flyboy-byte/wideband-work/work/STATE.md

# STATE — rusEFI wideband (module + carrier)

Status: 2026-10-25 — board r41 + B1 fix + **R9 pulse-proof (C844867, round 6 R6-S3; layout unchanged)**; firmware unchanged since 2026-10-24 (comments only). Seven audit rounds; **round 7 (Codex/Astra, PR #3, 2026-10-25): no BLOCKER or BUG**, verdict "yes for a supervised first prototype"; R7-S1 (surge is a conditional budget) and R7-S2/S3 (+5V load list, doc headers) answered in wording, A8 now measures the whole +5V load. The release gate read the oldest audit round (AUDIT.md lists newest first): fixed, `checks/test_release.py`. Round 6 (Codex/Astra, PR #2) found two checker bugs that let failures pass (stack checker cut real recursion through pointers; sim wrappers passed aborted runs): both fixed with regressions that fail on the old code; one surge risk fixed by the R9 swap; two risks accepted (backfeed under C1, bench A8; C11 edge rails at the quote). **Released `flyboy-o2-v1` (2026-10-25, `fab/flyboy-o2-v1/`, carrier + module). Next: the owner orders at JLC (`docs/ordering.md`); then bring-up, and the order (owner).** U9 pinout closed (Torex, via round 6). Costs, route, shopping list: `ROADMAP.md`.
Revision in progress: flyboy-o2-v1 (released, not ordered)   Revisions used (never reused): flyboy-o2-v1 (released 2026-10-25, not yet ordered). Upstream module exports are rev A, B, C (upstream's own scheme, not ours).
<If the project already names revisions its own way (v1.0.0), keep its scheme.>
Review pages: status report https://claude.ai/artifact/YRsjXKGZKG5AFbwkcMuYZ4 (private; rebuilt by `checks/report.py`)  fit check <link>  audit <link>

## Stages
Mark a stage done only when its exit condition is true. Strike through, don't delete.

| # | Stage | Exit condition | Done |
| --- | --- | --- | --- |
| 1 | Requirements | `REQUIREMENTS.md` answered by the owner; breakout/perfboard ruled out | |
| 2 | Parts | Every part in `parts_research.md` with pinout, land pattern, temp rating, stock, source URL; real 3D model seen for user-handled and tall parts | |
| 3 | Schematic | Generated from code; netlist self-check passes | 2026-10-24 (r41: ERC 0, self-check 18/18) |
| 4 | Fit check | Artifact page with the to-scale picture and size table (mm + in) approved by the owner | |
| 5 | Placement | Fixed parts and critical loops locked; back side checked | 2026-10-24 (r41: stage on the top, bypass caps 2.1-3.9 mm, bottom carries tracks only) |
| 6 | Routing | Best run chosen by DRC count, not router score; vias out of SMD pads | 2026-10-24 (r41: 0 new incl. fab warnings, 0 open, 0 vias in pads, layout review 0) |
| 7 | 3D and mechanical | Access check done for every user-handled part; renders looked at, then published and approved by the owner | renders looked at and published (status page v3); jumpers on open top area, holes copper-free; **owner approval pending** |
| 8 | Fab files | `checks/run_all.py` all PASS (DRC included, nothing skipped) on the current design | 2026-10-24 candidate in `work/out/carrier/`: 20 checks pass, raw upstream DRC advisory by D2 |
| 9 | Audit | `AUDIT.md` round with no open BLOCKER or BUG; earlier fixes re-confirmed | |
| 10 | Order | `checks/release.py` released `fab/<rev>/`; committed the same day; row in `ORDERS.md` | |
| 11 | Bring-up | Bring-up tests from `REQUIREMENTS.md` run and recorded below; RISK items checked; lessons in `LESSONS.md` | |

## Decisions already made (do not re-ask)
- 2026-10-23 Owner answers, asked interactively (C1-C3, D1-D11) — owner:
  - C2 receivers: all of Speeduino, K20Z3/FlashPro, an AFR gauge, and rusEFI over CAN. K20Z3 input resistance UNKNOWN: measure it at bring-up. Endpoint tolerance +-0.05 V after a one-time bench trim. Not a forced change: the shortfall (4.816 V max into 10k, Codex runs) only touches the top near 20 AFR and only into a low-resistance input. First measure the K20Z3 input with a multimeter; at 100k or more the trim reaches +-0.05 V as is; if low, simulate 68k -> about 75k or set the receiver table from measured volts (owner agreed 2026-10-23).
  - 2026-10-24 C2 build-around (owner: "build around it", no way to measure the receiver): 68k DC feedback moves to J3-5 after R11 (E). Simulated: 1-5 V within 3 mV into 4.7k-100k pull-downs and 10k-47k pull-ups; below 1 V into a pull-up still unverified. `docs/carrier.md` "Receiver load and the feedback point". In the next board run.
  - 2026-10-24 Silkscreen default (Claude, reversible; owner may override): labels at JLC's 1.0 mm / 0.15 mm minimum, only where a label clearly belongs to its part; the jumpers carry their function (TEST, 120R) instead of JP1/JP2; 13 crowded passives unlabelled (CPL and renders name them).
  - 2026-10-24 Upstream's `hardware/board_carrier/export/` files are stale (BOM 2023-01-05: SMCJ30CA/SS34, no C6-C10; positions before the 2023-02-03 re-placement). Part numbers come from the board's LCSC fields: D1 SMCJ24CA C151279, D2 SS54 C22452 (DOCUMENTED, upstream git).
  - 2026-10-24 Mounting holes isolated: no copper within 3.6 mm of H1/H2 on either layer (Claude default, r41; the owner suggested a plastic washer instead, which still works; a grounded case via plated holes would be the owner's call).
  - D9 caveat: moving the stage to the top re-places a clean board to save an unpriced fee; price the two-sided fee first and come back to the owner if the saving is small.
  - C1 12-16 V on J3-5: no survival requirement ("how bad would i have to be"); R11 470R stays as limiting only; accepted risk. Realistic route: J3-5 sits between J3-6 (12V_RAW) and J3-4 (heater+), so a solder bridge or misplug.
  - C3 grounding: star at the ECU sensor ground. J3-1 power ground to block/battery; J3-7 only to the receiver's sensor ground; A4 measures the offset.
  - D1 R9 -> 1206. D2 gate on "DRC vs upstream" instead of raw DRC, plus a dated C7 waiver. D7 no separate analog ground. D8 two M3 holes in the new bottom corners. D9 analog stage, R10 and JP2 to the top (one-sided assembly). D10 add the IWDG watchdog. D11 keep the 13 V assumption.
- 2026-10-23 No size limit from upstream's `case/case.STL`: the owner designs his own enclosure in CAD ("what case. i do cad"). The carrier may grow; not going upstream, so no compatibility to keep. Next: fit check for a larger outline (about 40 x 52 mm), analog stage to the top if it fits, D6 series resistor — owner.
- 2026-10-23 Test and audit effort goes to the big things: circuits (analog stage, power), the heater drive, the control loops (heater, pump) and firmware. Lighter checks for routine parts and docs — owner.
- 2026-10-23 No simulated-narrowband output. FlashPro use is datalogging over the 0-5 V input; stock ECU closed loop stays on its narrowband sensor — owner.
- 2026-10-23 Base stays the f0 module + a new carrier; lambda-x2 is not forked (its analog out is the same circuit). Copy its output stage, add a reference buffer and trim — owner ("keep going").
- 2026-10-23 `AGENTS.md` is the authoritative guide for all models; Codex audits follow its "Cross-model audits" section — owner asked for documentation for us, subagents and Codex.
- ~~2026-10-23 Work in a separate repo, upstream clone stays untouched~~ — replaced the same day: one repo `~/projects/wideband-work` = upstream clone + branch `analog-out` + our files in `work/`; the separate notes repo and the `rusefi-hardware` clone were deleted — owner ("combine and delete").
- 2026-10-23 Intent: build and order the upstream design as is, then adapt it — owner ("both").
- 2026-10-23 Upstream's `hardware/*/export/` files are upstream releases, not evidence of anything the owner ordered.

- 2026-10-23 Aftermarket LSU 4.9 accepted; receivers wanted: rusEFI, Speeduino, K20Z3/FlashPro, carb tuning with a dash or gauge — owner.

- 2026-10-23 Owner wants to build this board ourselves and learn from it, not buy a ready-made unit; the point is the design and testing — owner.

## Checks
<!-- checks:start -->
| Check | Result | Summary | Date | Files (sha256/12) |
| --- | --- | --- | --- | --- |
| DRC module (errors) | FAIL (advisory) | DRC 11 errors: solder_mask_bridge 10, clearance 1 (report checks/out/wideband_controller-drc.json) | 2026-10-25 | `wideband_controller.kicad_pcb` 0179d031bc63 |
| Module board identical to upstream | PASS | module board vs upstream master: 0 file(s) differ | 2026-10-25 |  |
| ERC module (errors) | PASS | ERC 0 errors (report checks/out/wideband_controller-erc.json) | 2026-10-25 | `wideband_controller.kicad_sch` e54843a1e6ef |
| DRC carrier (errors) | FAIL (advisory) | DRC 23 errors: courtyards_overlap 14, copper_edge_clearance 3, malformed_courtyard 3, starved_thermal 2 (report checks/out/board_carrier-drc.json) | 2026-10-25 | `board_carrier.kicad_pcb` 986aced34840 |
| Carrier DRC vs upstream baseline (new violations, unconnected) | PASS | DRC vs upstream: 0 new violations, 0 unconnected | 2026-10-25 | `board_carrier.kicad_pcb` 986aced34840 |
| Carrier: no new vias in SMD pads | PASS | via in pad: 0 new, 0 upstream | 2026-10-25 | `board_carrier.kicad_pcb` 986aced34840 |
| Carrier layout review (sampled coupling and return-path heuristics) | PASS | review triggers: 0 | 2026-10-25 | `board_carrier.kicad_pcb` 986aced34840, `layout_review.py` 2dfa9e8efa14, `layout_metrics.py` 23c78d58fd8a |
| Layout geometry helper unit tests | PASS | OK | 2026-10-25 | `layout_metrics.py` 23c78d58fd8a, `test_layout_metrics.py` 2d93b205dd56 |
| Layout track-order regression | PASS | PASS: tested orders agree | 2026-10-25 | `board_carrier.kicad_pcb` 986aced34840, `layout_review.py` 2dfa9e8efa14, `layout_metrics.py` 23c78d58fd8a, `audit_layout_order.py` c40bda9f97e2 |
| ERC carrier (errors) | PASS | ERC 0 errors (report checks/out/board_carrier-erc.json) | 2026-10-25 | `board_carrier.kicad_sch` 7899a4c38db8 |
| Carrier netlist self-check (generator table) | PASS | netlist self-check: 18 nets, 0 problems | 2026-10-25 | `board_carrier.kicad_sch` 7899a4c38db8, `gen_carrier_sch.py` bc7a0b98744c |
| No hand edits waiting | PASS | no drift | 2026-10-25 |  |
| JLC rotation, origin and pin names from each part's EasyEDA footprint | PASS | jlc rotation: 38 parts measured, 4 need a correction, 0 problem(s) | 2026-10-25 | `board_carrier.kicad_pcb` 986aced34840, `board_carrier.kicad_sch` 7899a4c38db8 |
| Fab candidate (out/carrier) matches the board: Gerbers, BOM, CPL, not-fitted | PASS | fab files: 38 placed, 6 not fitted, outline 40.00 x 51.50 mm, 0 problem(s) | 2026-10-25 | `board_carrier.kicad_pcb` 986aced34840, `carrier-bom.csv` 4929cced2179, `carrier-cpl.csv` 66a7fdc2200c, `carrier-gerbers.zip` c6d03f1de870 |
| Firmware: bootloader DATA writes stay inside the app partition (F1) | PASS | 52 guard cases; 0 unsafe accepted writes, 0 valid writes refused (stub only) | 2026-10-25 | `bootloader.cpp` 21cbac0cd469, `bootloader_bounds.h` 72e216e2e7bc |
| Firmware: package checker accepts good images, rejects bad ones (F2) | PASS | 21 package cases, 0 wrong verdict(s) | 2026-10-25 | `fw_package.py` 34a1c5eb78dd, `wideband_image.h` 1ee39ace5944, `bootloader.cpp` 21cbac0cd469 |
| Firmware: HardFault entry reaches the C handler on a Cortex-M0 (F9, QEMU microbit) | PASS | fault entry on Cortex-M0: as expected | 2026-10-25 | `main_hardfault_asm.S` d32262764759, `main.cpp` f1c2e96ebf08 |
| Firmware: host gtest suite (sampler, heater, F7, F1 bounds, D10 watchdog) | PASS | [  PASSED  ] 70 tests. | 2026-10-25 | `heater_control.cpp` 7368eb50561e, `sampling.cpp` 8a229de01887, `watchdog.h` 3c55e521fda5, `bootloader_bounds.h` 72e216e2e7bc |
| Firmware: analog output host tests, production auxout/pump_dac/can_helper on the f0 config (F3-F6) | PASS | [  PASSED  ] 21 tests. | 2026-10-25 | `auxout.cpp` 417044786829, `pump_dac.cpp` ac1d4bf351de, `can_helper.cpp` 0dd77d348207, `aux_curve.h` bb88ea23e570, `wideband_board_config.h` 75af39efb19f |
| Firmware: static worst-case stack per thread fits (F8 estimate, f0 build) | PASS | stack estimate: ok, smallest margin 92 B | 2026-10-25 | `auxout.cpp` 417044786829, `can.cpp` 65a7078908bf, `heater_thread.cpp` 1c61085261f8, `pump_control.cpp` 6449053857fe, `sampling_thread.cpp` 65d58bbf0b52 |
| Stack checker: known-answer Cortex-M0 cases incl. a pointer in a literal pool (Codex R41-CX1) | PASS | stack checker cases: 4, 0 wrong verdict(s) | 2026-10-25 | `stack_estimate.py` b4a89208d6a3 |
| Sim wrappers fail when ngspice gives no valid result (Codex R41-CX2) | PASS | sim wrappers: 0 wrong verdict(s) | 2026-10-25 | `stability.sh` b5a591f40734, `load_accuracy.sh` ff3f503474e9 |
| Output low from reset until the app drives PB1 (R3 vs the PB1 pull in both board.h; outside review B1) | PASS | boot level: output low from reset | 2026-10-25 | `board_carrier.kicad_pcb` 986aced34840, `board.h` 0a70a2bb2fa0, `board.h` 1dc40c1c92c0 |
| Module order files: JLC rotation, origin and pin names from EasyEDA against the order CPL (upstream rev C + fixes) | PASS | jlc rotation: 57 parts measured, 6 need a correction, 0 problem(s) | 2026-10-25 | `wideband_controller.kicad_pcb` 0179d031bc63, `module_fab.py` fe36cd34cf0f, `jlc_rotation.py` b1455144624f |
| Reviewer docs agree with the repo (REVIEW.md check count, TASKS.md IDs and files, pack contents) | PASS | review docs: 0 problem(s) | 2026-10-25 | `REVIEW.md` 4ca0666dfb44, `TASKS.md` d7455f56fb34, `FINDINGS-TEMPLATE.md` 7d85be0c9a6e, `review_pack.sh` fbeab94d332c, `checks.json` 65fa8b4c7038, `AUDIT.md` 50b4673514ca |
| Op-amp supply survives a clamped load dump: R9 and D5 power within rating (Codex round 6, R6-S3) | PASS | surge budget: 0 problem(s) | 2026-10-25 | `board_carrier.kicad_pcb` 986aced34840, `surge_budget.py` a12d878ff9c3 |
| Release gate judges the latest audit round, wherever AUDIT.md lists it (Codex round 7 follow-up) | PASS | release gate rounds: 4/4 right | 2026-10-25 | `release.py` cc666e23c085, `test_release.py` 3cb68936a838 |

Written by `checks/run_all.py` at commit 9481317. Don't edit by hand.
<!-- checks:end -->

## Bring-up results
| Test | Board # | Reading | Pass? | Date |
| --- | --- | --- | --- | --- |

## Firmware tested on
| Board revision | Firmware commit | Result |
| --- | --- | --- |

## Open register (2026-10-25)
- 2026-10-25: round 6 answered in `AUDIT.md` (all 8 findings: 5 fixed, 2 accepted, plus doc items). Design change: R9
  C4410 -> C844867 (Claude's call under the owner's 2026-10-24 delegation; +$3 Extended fee, +$0.48 parts for 5 boards;
  REPORTED). Its check: `checks/surge_budget.py` (fails on C4410); bench: none possible on the owner's bench (no
  surge source), so the check and round 7 TK3 carry it. Round 7 hand-off and `review/TASKS.md` (TK1-TK7) ready.
- PR #2 (Astra's review folder only) merged to keep the raw report with its round.

## Open register (2026-10-24, end of session)
- 2026-10-24 late: reviewer docs rebuilt for a cold agent (owner: Astra Codex "didn't really know what all to do and how
  to help"). `REVIEW.md` leads with three rules (work without waiting, write as you go, stop at a quarter budget) and
  two routes (agent with the repo; chat with one zip). Work list `review/TASKS.md` (TK1-TK13), report
  `review/FINDINGS-TEMPLATE.md` (coverage row per task, two worked examples), chat prompt `review/PROMPT.md`. The pack
  gained plain-text part and net lists for both boards (`checks/pack_extras.py`), the module Gerbers, `INDEX.md` and a
  zip; the old pack silently lost the carrier's README and not-fitted list (same basenames as the module's;
  `audit_pack.py` now refuses that). New check `checks/review_docs.py` (count, task IDs, pack files, scripts). Local
  only: not pushed.
- Owner (2026-10-24, do not re-ask): don't send our lessons back to the cousin's skill.
- 2026-10-24 evening: owner delegated B1/N1/R1 and the heater clamp to Claude and said push everything (his cousin's review, Codex's PR and second pass, our tests). Done: `AUDIT.md` rounds 4 and 5 with follow-through; `ROADMAP.md` for the route. Watch for a PR from the cousin (he may not be finished) or anyone else.
- 2026-10-24 External-review prep done: `REVIEW.md`; checks use `origin/master` when a clone has no local `master` (`checks/upstream_ref.py`); reviewers' raw output under `audit/<reviewer>-<date>/` is now tracked (packs are not); a fresh clone ran all 20 checks after building bootloader + app (stack check needs the ELF). pcb-design skill lessons added (pad pairing by pin function, fab warnings in the DRC gate, BOM from the board, independent fab-file check, outside reviewers, SPICE memory): dotfiles commit 70aa5e9, pushed 2026-10-24.
- Owner (do not re-ask): engine-bay heat is not a design driver for this prototype.
- Owner (2026-10-25, do not re-ask): first order is 1-2 controllers. JLC makes 5 bare PCBs minimum and can assemble 2 of them (FROM MEMORY; check the quote), so assemble 2 carriers + 2 modules; the other 3 of each stay bare as spares. Same released files, quantity set on the order page.
- Owner (2026-10-25, do not re-ask): the module is **socketed** on the carrier (Mill-Max 310 sockets + 350 pins, `ROADMAP.md`); no board change. Round 8 OR1/OR2 answered in AUDIT.md; OR3 (order notes) and OR4 (first-power source) open.
- Owner (2026-10-25): **one order only, make or break.** Order on hold until a pre-order first-run risk pass: every way the first power-up, flash or sensor run can fail, whether it is recoverable with an iron, meter or reflash, and what closes it before ordering. Goal: no failure that only a second order can fix.
- Owner (2026-10-24, do not re-ask): first-flash hardware (D4) = HiLetgo ST-Link V2 clone + TC2030-IDC-NL + jumpers (`docs/wiring.md`).
- ~~Owner (2026-10-24): no pushing or merging until the outside reviewer (his cousin's Opus) has audited; keep working locally.~~ Lifted 2026-10-24 late (owner: the cousin isn't contributing now, push it all); review docs pushed `d801998`. Round 6 next: Astra (Codex) on this machine, started from the route B prompt in `REVIEW.md`. Upstream's own analog output (PR #352, merged 2026-10-24) is not used: we use our design (`docs/analog-out.md`).
- 2026-10-24 Codex round 4 on fork PR #1 (not merged). CX1 stack checker and CX2 sim wrappers fixed locally (`AUDIT.md`, follow-through part 1). Upstream heater bug (negative voltage squared to full duty when the sensor runs hot): fix prepared on local branch `heater-clamp`, owner decides.
- **Board/fab**: audit round 4 (Codex, plus an outside Opus reviewer via `REVIEW.md`): ~~rebuild the pack first~~ done 2026-10-24 at r41 (`checks/review_pack.sh`). ~~Push needed before an outside reviewer can clone~~ pushed 2026-10-24. JLC quote (owner): Gerbers in JLC's viewer, placement preview (D2 first), stock C13585/C14663/C15849/C7934, edge rails (C11 1.85 mm from edge), Basic 470R 1206 for R11. ~~TODO `docs/ordering.md`~~ written 2026-10-24 (quote steps, options, placement-preview list, substitution rule, APIs).
- **Module board (not prepared)**: upstream rev C exports current (2026-03-22); 4 layers, 29.0 x 20.9 mm, 60 parts; J1/J3 headers bottom (owner solders), J2 Tag-Connect pads. Run our rotation/fab checks on it.
- **Firmware**: never run on hardware; first-flash hardware unchosen (D4, money); trim needs reflash per board; watchdog heater loop only (W1); stack high-water on hardware; RAM 0 B free; F1/F9 not reported upstream (owner).
- **Deeper tests not done**: R9/D5 surge (Codex C6); 12 V on J3-5 as built (C1 accepted); supply corners: 5 V into 100k holds from 7.5 V battery up (4.34 V at 6 V); 4.7k and 7 V runs gave no result, redo; drift budget INFERRED: 60 C swing worst 40 mV at 5 V.
- **Bench**: T1, A1-A4 (A3 about 6 mA), W1, H1-H6.
- ~~More 3D views~~ done 2026-10-24: `renders/carrier-f/iso-{front,back,bottom}.png` (kicad-cli `--perspective --rotate`), on the status page v4.

## Open (older notes, 2026-10-23)
- 2026-10-23 Flashing/testing scoped in `docs/flashing-and-test-plan.md`: recommend SWD first-flash/recovery, exact probe/cable/power unchosen. Fresh native build passes 43 tests (leak check disabled due environment), not aux-output coverage. F1: bootloader DATA guard permits config-page writes; reproduced with actual guard + flash stub. Next: fix/test F1, validate image packaging, add aux-output host tests. No hardware flashing or purchases.
- 2026-10-23 Codex follow-up: layout metric repaired and regression-tested; PWM return review flag is 6.8 mm (C7). Four ramped full-scale model runs succeeded: about 5.019 V into 100k, 4.816 V into 10k, at protected supplies 12 V and 7.5 V. C1/C2/C3 remain open. Default: retain components until load/tolerance and clamp/sink behavior are jointly budgeted. 80R instead of 470R is not a standalone accuracy fix. See audit report follow-up. Long paragraph below is historical context, not current layout status.
- Analog output: `docs/analog-out.md`, `docs/carrier.md`, `docs/firmware.md`, `sim/analog_out.cir`. Firmware on branch `analog-out` builds (2026-10-23): PB1/TIM3_CH4, updated from the CAN TX thread, compiled-in 10-20 AFR curve, 0 V while invalid, full scale 5.04 V; 4.8 KB flash, 8 B RAM left; untested on hardware. Carrier analog stage proposed with parts (REF3030 C38423, 74LVC1G125 C12519, LM2904DR C7934, BAT54S C47546) and a behavioral filter simulation (0.7 mV ripple, 4.1 ms settling). Op-amp stability checked with TI's LM2904 model: feedback after the 330R oscillates; dual loop with Cf 1 nF has no overshoot from 1 pF to 47 nF (`sim/stability.sh`). Firmware test mode (SEL_2 low at power-up) and compiled-in trim added; RAM now full to the byte (no runtime allocation, so safe). Carrier schematic generated from code (`gen/gen_carrier_sch.py`, A3 sheet, upstream drawing kept): ERC 0 errors, netlist self-check 17/17 nets (2026-10-23). Carrier PCB in progress (`gen/gen_carrier_pcb.py`, 2026-10-23): new parts on the bottom (board can't grow inside `case/case.STL`; case clearance under the board about 6 mm, INFERRED); placed by an annealing placer (net length + distance to existing copper), GND fan-out vias and +5V tap vias before routing, Freerouting 2.5.0 with upstream tracks locked, then a grid finisher (`gen/finish_routes.py`) for what Freerouting leaves. Passives moved to 0402 where the rating allows (2026-10-23, to free bottom area; R6/R8/R9/C16/C17 stay 0603/1206). Analog-stage nets routed by negotiated routing (`finish_routes.negotiate`) before Freerouting. Routing closed 2026-10-23 (r32): `checks/drc_vs_upstream.py` = 0 new violations, 0 unconnected; the last open connection (D3 clamp to +5V) was fixed by `close_d3_link` in the generator, found with `checks/whatif_route.py`. **Not done (updated 2026-10-23 evening):** self-audit done, see `RELEASE_ASSESSMENT.md`; firmware fix R4 (CAN thread no longer waits 100 ms with no node on the bus); the C17 move was tried (r33, weighting `/VOP12`) and reverted (6 open). C17 sits 4.5 mm from U6 pin 8 (fix before review); silkscreen overlaps; audit (pack in `work/audit/carrier-d-2026-10-23/`, hand-off in `AUDIT.md`); BOM/CPL and JLC quote. Run history and next steps in `HANDOFF.md`. The board file in the repo is this WIP state; don't order from it (release.py would refuse anyway). For the audit: R8 (330R) and R9 (1k) are 0603 (100 mW); an AOUT short to GND or a load-dump surge into the zener exceeds that briefly or steadily (INFERRED, not simulated); consider 0805/1206 or a pulse-rated part. Open: how the owner will flash the module (SWD probe or rusEFI over CAN). Open: invalid-output value (owner), owner to confirm tests A1-A3.
- Baseline checks on upstream at its HEAD (2026-10-23, error level): module DRC 11 / ERC 0; carrier DRC 29 / ERC 8. Not yet judged as real or harmless.
