flyboy-byte/wideband-work/work/audit/astra-2026-10-25b/PR-BODY.md

## Verdict

Suitable for a supervised first prototype after the existing factory rail/placement checks; not a qualified automotive/fault-survival product. No new BLOCKER or BUG found in this targeted round. Design baseline **18b6cef4c5ca249423fce5a9924ea7fc53124220**.

## Evidence

- TK1: prior recursion counterexample now fails;4/4regressions pass.40BLX sites/source target sets checked,current worst thread margin92B with stated assumptions.
- TK2:26sim-failure verdicts correct,actual aborted outputs rejected;real25case stability sweep completes,0%overshoot through10nF as-built.
- TK3: HP R9 nominal overload fixed(0.480W with tolerance vs conditional0.75W rating). D5 derating and actual400ms TVS envelope still qualify survival claims.
- TK4: no guaranteed13.6mA minimum+5V sink. LM2904 is on VOP12,not+5V. Keep accepted C1 prototype trade-off;no no-layout swap recommended without normal-operation revalidation.
- TK5: fresh26BOM/38CPL match;R9 geometry unchanged;all26live stock lines sufficient for5boards. Full suite26checks,0nonadvisory failures,2accepted DRC advisories,0skips;report isolation verified. C11 factory rail approval remains order-time gate.
- TK6:19new ASan/UBSan cases exercise real sampler+heater:synthetic ESR fault invalid526–576ms,DC fault firstsample;ADCstall confirms known freshness limitation. Not physical unplug qualification.
- TK7: concrete doc corrections proposed;coverage/verdict/handoff complete.

Only **work/audit/astra-2026-10-25b/** changes. Each TK has its own commit. No design changes,ordering,flashing,merge or pushes to analog-out/main.

Start with `work/audit/astra-2026-10-25b/FINDINGS.md`,then `HANDOFF.md` in the same folder. Commands,raw outputs,checks JSON and candidate BOM/CPL evidence are retained alongside them. TI's licensed model is not committed.
