flyboy-byte/wideband-work/work/audit/astra-2026-10-25/HANDOFF.md

# Round6 reviewer handoff

Performed2026-10-24; folder/branch2026-10-25 per owner's request. Reviewed design e0b802a5ca53d679b9fa85e5889658d3f74d6dab. Every commit on review/astra-2026-10-25 changes only this audit folder. PR:https://github.com/flyboy-byte/wideband-work/pull/2

Read FINDINGS.md first. Complete coverage TK1–TK13 plus TK99;2BUG,3RISK,3NOTE. Verdict: not yet a release/order package. No design files changed, no flash/order. Original owner's KiCad carrier lock preserved. Check-generated timestamp-only diffs outside the audit were restored precisely; no unrelated edits reverted.

## Designer's next steps

1. Verify **R6-S6** using stack_indirect_cycle.py/TK12-indirect-cycle.S. A real indirect recursive helper allocates108B per level; current checker passes116/256B. Reject cycles unless infeasibility is proved; avoid the verbose-path hang. Existing3regressions all pass and miss this case.
2. Verify **R6-S8** with sim_zero_regression.py and actual TK6c-long-*.out. Aborted analyses can emit finite zeros. Require final time/window completion and reject abort diagnostics; extend regressions to full_scale_corners.sh. The audit's own initial PASS labels are also superseded explicitly in TK99-sim-validation.md.
3. Obtain JLC rail/panel acceptance for C11. Published requirement is2.5mm from **body**, not center; current body clearance~1.60mm.5mm rails may resolve it without moving the circuit.
4. Resolve/qualify/explicitly accept the power-off backfeed and exact-part400ms surge risks. Do not claim current limiting proves ECU protection or continuous power rating proves pulse survival.
5. Correct3mVtyp vs7mVmax LM2904 offset; qualify optional ground-fuse protection; delay stability step to a settled baseline. Rebuild next audit pack after designer changes; preserve this review's raw output separately.

## Evidence worth reusing

- TK1-rows.md:26BOM/38CPL rows; TK2-rotation.log:57module placements. Torex primary PDF settles U9 pinout correctly.
- TK5-recovery-fixed.log:60s hot clamp then recovery;30cycles. Initial compile failure retained. Source tests are actual controller/PID with mock sampler/time, not thermal simulation.
- TK6-fullscale.log:27nominal values; raw-completion proof is only the3selected TK6-raw-*.out cases. Accepted deficit endpoints4.9338/4.8218V directly reproduced with valid60ms windows.
- TK6c-zero-*.out: model floor0.517V into4.7kdown/1.298V into4.8V pull-up; physical low-end remains unverified.
- TK7-delayed.log: settled baseline,0%overshoot to10nF,9.2%47nF,22.8%100nF. Typical model/12V/100k, not phase margin or process corners.
- TK12-checks.json:25checks,23passes,2accepted advisory failures. Fresh isolated build imageCRC984fc2b4,21616Bapp; no dynamic allocation symbols/heap space. Stack margin not proven.

Simulator quirk: run TI model with sim/.spiceinit(`ngbehavior=psa`). 'Exit0+finite numbers' is insufficient. Extra120ms/20us-timestep supply-start attempts failed numerically and are not circuit failures. Original queue ran all25A–E cases before the focused delayed E rerun; no raw run is silently relabeled.

Reproducers intentionally return0 when they reproduce the current checker bug; after a fix their expectations must be inverted into normal regression tests. Preserve historical evidence instead of overwriting it in another review folder. Strong-model follow-up can focus on R6-S2/S3 circuitry and the proposed checker proofs rather than rerunning all routine checks.
