flyboy-byte/wideband-work/work/audit/astra-2026-10-25/PR-BODY.md

Independent round6 review of design commit `e0b802a` on `analog-out`, covering TK1–TK13 plus a simulator-validation counterexample. Only `work/audit/astra-2026-10-25/` changes; no circuit, layout or production firmware changes.

Verdict: not yet an order/release package. Two reproducible verification bugs remain:

- **R6-S6:** actual indirect recursion is reported as116/256bytes and passes; verbose path printing hangs.
- **R6-S8:** ngspice can abort early yet return finite zero measurements; the production full-scale wrapper accepts27/27 injected aborted-zero cases.

Other findings: obtain JLC rail acceptance for C11's~1.60mm body clearance against the published2.5mm requirement; qualify the existing rail-backfeed and surge risks; correct LM2904 offset limits, fuse-protection wording and pre-step settling metrics. No new proven reversed part, open connection or production heater-control defect was found.

Validation:70host+21auxiliary+2new heater recovery tests pass; fresh firmware package builds and passes CRC/vector checks;25configured checks yield23passes and2accepted upstream advisory DRC failures. Nominal27case analog sweep reproduces;3selected corners independently retain raw60ms completion. Delayed-baseline step tests show0% overshoot through10nF,9.2% at47nF. Two extended supply-start analyses abort and remain explicitly unverified.

See `FINDINGS.md` for all8findings, per-task coverage, evidence tags and limitations. `HANDOFF.md` names the smallest next steps. No boards ordered or flashed. Review started before the owner's Astra→6.1Sol switch and continued afterward; it is one continuous reviewer, not two independent audits.
