flyboy-byte/wideband-work/work/audit/astra-2026-10-25/TK7-stability.md

# TK7 stability method review

DOCUMENTED: sim/stability.sh as-built E uses DC feedback from connector through68k, local1nF feedback from op-amp output,330+470ohm isolation,100k receiver,12V ideal rail,0.1V input step. The original queue had loaded its earlier code and ran all25A-E cases(TK7-stability.log). A focused E rerun waits3ms before the step and measures through6ms(TK7-delayed.log), recording source hash.

INFERRED: the isolation resistance limits direct capacitive loading of the output; local feedback takes over above the68k/1nF frequency scale(~2.34kHz). A bounded, decaying step response across the requested capacitances supports nominal closed-loop stability. It does not prove phase margin, all-parts stability, or response after saturation.

MEASURED delayed E results:0% overshoot at1pF/1nF/10nF,9.2% at47nF,22.8% at100nF;1% settling258/255/219/95/609us. All have late ripple printed0.00mV. Baseline1.6823V,terminal1.8503V. Original400us step test at10nF starts from1.7532V, not settled1.6823V;100nF overshoot was28.0% from an even more disturbed baseline. R6-S7: require settled baseline before quoting overshoot; nominal0..10nF conclusion survives the correction. These are completed nominal step tests, not a phase-margin measurement.

Limits of the test: one positive step around1.7-1.85V output,100k resistive load,ideal12V source,no clamp conduction,one macromodel and temperature. Neither negative steps nor the4.7k receiver/supply corners are covered. The TI model is typical; output crossover, current-limit recovery, saturation recovery, supply-startup behavior and process spread may differ from hardware. A loop-gain injection test (maintaining the DC operating point and both feedback paths) is appropriate for phase margin. Bench step/oscillation tests at several output levels and real cable loads would complement it. No phase-margin value is invented from overshoot.
