flyboy-byte/wideband-work/work/audit/claude-sidewinderzz-2026-10-24/netlist-from-board.txt

C1 1u C15849 1=/LSU_Heater+ 2=GND
C10 10u C13585 1=/LSU_Heater+ 2=GND
C11 100n C1525 1=+5V 2=GND
C12 100n C1525 1=/VREF3 2=GND
C13 100n C1525 1=/AOUT_F1 2=GND
C14 100n C1525 1=/AOUT_F2 2=GND
C15 1n C1523 1=/AOUT_OA 2=/AOUT_INN
C16 10u C13585 1=/VOP12 2=GND
C17 100n C14663 1=/VOP12 2=GND
C2 1u C15849 1=+5V 2=GND
C3 1u C15849 1=Net-(U1-VIO) 2=GND
C4 47p C1567 1=GND 2=/CAN_H
C5 47p C1567 1=/CAN_L 2=GND
C6 22u C45783 1=+5V 2=GND
C7 10u C13585 1=12V_RAW 2=GND
C8 10u C13585 1=GND 2=12V_RAW
C9 10u C13585 1=12V_RAW 2=GND
D1 D_TVS C151279 1=12V_RAW 2=GND
D2 D_Schottky C22452 1=/LSU_Heater+ 2=12V_RAW
D3 1N4148WS C2128 1=+5V 2=/AOUT
D4 1N4148WS C2128 1=/AOUT 2=GND
D5 18V C173425 1=/VOP12 2=GND
H1 MountingHole_3.2mm_M3 - 
H2 MountingHole_3.2mm_M3 - 
J3 Conn_02x06_Top_Bottom - 1=GND 2=/LSU_Ip 3=/LSU_Heater- 4=/LSU_Heater+ 5=/AOUT_J 6=12V_RAW 7=GND 8=/LSU_Vm 9=/LSU_Rtrim 10=/LSU_Un 11=/CAN_H 12=/CAN_L
JP1 TEST - 1=/TEST_SEL2 2=GND
JP2 CAN_TERM - 1=/CAN_TERM 2=/CAN_L
R1 220 C22962 1=+5V 2=Net-(U1-VIO)
R10 120 C25079 1=/CAN_H 2=/CAN_TERM
R11 470 C4502 1=/AOUT 2=/AOUT_J
R2 470 C23179 1=Net-(U1-VIO) 2=GND
R3 100k C25741 1=/AOUT_PWM 2=GND
R4 3.3k C25890 1=/AOUT_BUF 2=/AOUT_F1
R5 3.3k C25890 1=/AOUT_F1 2=/AOUT_F2
R6 68k C23231 1=/AOUT_J 2=/AOUT_INN
R7 100k C25741 1=/AOUT_INN 2=GND
R8 330 C23138 1=/AOUT_OA 2=/AOUT
R9 1k C4410 1=/LSU_Heater+ 2=/VOP12
U1 TJA1051T-3 C38695 1=/CAN_TX 2=GND 3=+5V 4=/CAN_RX 5=Net-(U1-VIO) 6=/CAN_L 7=/CAN_H 8=GND
U2 LM78M05_TO252 C58069 1=/LSU_Heater+ 2=GND 3=+5V
U3 f042_wideband_module - 1=+5V 2=GND 3=/AOUT_PWM 4=/TEST_SEL2 5=/CAN_RX 6=/CAN_TX 7=/LSU_Heater+ 8=unconnected-(U3-Boot0-Pad8) 9=GND 10=GND 11=/LSU_Heater- 12=/LSU_Heater- 13=/LSU_Ip 14=/LSU_Vm 15=/LSU_Rtrim 16=/LSU_Un
U4 74LVC1G125 C12519 1=GND 2=/AOUT_PWM 3=GND 4=/AOUT_BUF 5=/VREF3
U5 REF3030 C38423 1=+5V 2=/VREF3 3=GND
U6 LM2904 C7934 1=/AOUT_OA 2=/AOUT_INN 3=/AOUT_F2 4=GND 5=GND 6=/U6B_FB 7=/U6B_FB 8=/VOP12
