flyboy-byte/wideband-work/work/report/index.html

rusEFI wideband + 0-5 V analog out · carrier board · 2026-10-24 · commit ba01449 · branch analog-out

# Wideband Carrier Status

Board r41 + B1 fix (2026-10-24): output held at 0 V from reset (R3 4.7k, PB1 pull-down), invalid lambda reads 5 V (lean end), heater no longer heats a hot sensor. Five audit rounds; round 6 (re-audit of these changes) is next, then your JLC order: about $180-215 for 5 carriers + 5 modules, every part in stock. Route and shopping list: work/ROADMAP.md.

## Checks

Result | Check | Detail
FAIL | DRC module (errors) | DRC 11 errors: solder_mask_bridge 10, clearance 1
PASS | Module board identical to upstream | module board vs upstream master: 0 file(s) differ
PASS | ERC module (errors) | ERC 0 errors
FAIL | DRC carrier (errors) | DRC 23 errors: courtyards_overlap 14, copper_edge_clearance 3, malformed_courtyard 3, starved_thermal 2
PASS | Carrier DRC vs upstream baseline (new violations, unconnected) | DRC vs upstream: 0 new violations, 0 unconnected
PASS | Carrier: no new vias in SMD pads | via in pad: 0 new, 0 upstream
PASS | Carrier layout review (sampled coupling and return-path heuristics) | review triggers: 0
PASS | Layout geometry helper unit tests | OK
PASS | Layout track-order regression | PASS: tested orders agree
PASS | ERC carrier (errors) | ERC 0 errors
PASS | Carrier netlist self-check (generator table) | netlist self-check: 18 nets, 0 problems
PASS | No hand edits waiting | no drift
PASS | JLC rotation, origin and pin names from each part's EasyEDA footprint | jlc rotation: 38 parts measured, 4 need a correction, 0 problem(s)
PASS | Fab candidate (out/carrier) matches the board: Gerbers, BOM, CPL, not-fitted | fab files: 38 placed, 6 not fitted, outline 40.00 x 51.50 mm, 0 problem(s)
PASS | Firmware: bootloader DATA writes stay inside the app partition (F1) | 52 guard cases; 0 unsafe accepted writes, 0 valid writes refused (stub only)
PASS | Firmware: package checker accepts good images, rejects bad ones (F2) | 21 package cases, 0 wrong verdict(s)
PASS | Firmware: HardFault entry reaches the C handler on a Cortex-M0 (F9, QEMU microbit) | fault entry on Cortex-M0: as expected
PASS | Firmware: host gtest suite (sampler, heater, F7, F1 bounds, D10 watchdog) | [ PASSED ] 70 tests.
PASS | Firmware: analog output host tests, production auxout/pump_dac/can_helper on the f0 config (F3-F6) | [ PASSED ] 21 tests.
PASS | Firmware: static worst-case stack per thread fits (F8 estimate, f0 build) | stack estimate: ok, smallest margin 64 B
PASS | Stack checker: known-answer Cortex-M0 cases incl. a pointer in a literal pool (Codex R41-CX1) | stack checker cases: 3, 0 wrong verdict(s)
PASS | Sim wrappers fail when ngspice gives no valid result (Codex R41-CX2) | sim wrappers: 0 wrong verdict(s)
PASS | Output low from reset until the app drives PB1 (R3 vs the PB1 pull in both board.h; outside review B1) | boot level: output low from reset
PASS | Module order files: JLC rotation, origin and pin names from EasyEDA against the order CPL (upstream rev C + fixes) | jlc rotation: 57 parts measured, 6 need a correction, 0 problem(s)

Module DRC (11) and carrier DRC (23) are upstream's own errors, advisory by your decision D2. "vs upstream" counts only what we added, including fab-relevant warnings.

## The board now

Top view, 3D render (KiCad 10), r41 + B1 fix (2026-10-24): upstream carrier grown 15 mm (40.0 x 51.5 mm, 1.57 x 2.03 in); the analog stage, both jumpers and the M3 holes in the new strip.

Top view, 3D render (KiCad 10), r41 + B1 fix (2026-10-24): upstream carrier grown 15 mm (40.0 x 51.5 mm, 1.57 x 2.03 in); the analog stage, both jumpers and the M3 holes in the new strip.

Bottom view (mirrored), r41 + B1 fix: tracks only in the strip, copper-free rings around the holes.

Bottom view (mirrored), r41 + B1 fix: tracks only in the strip, copper-free rings around the holes.

Angled, perspective (r41 + B1 fix): the new strip in front, the sensor connector behind.

Angled, perspective (r41 + B1 fix): the new strip in front, the sensor connector behind.

From the connector end: the stage and the module footprint.

From the connector end: the stage and the module footprint.

Underneath: the pad labels (AOUT, GND, CAN, LSU pins) and the copper-free rings around the M3 holes.

Underneath: the pad labels (AOUT, GND, CAN, LSU pins) and the copper-free rings around the M3 holes.

## Before and after: the stage moves to the top

r36 had the analog stage on the bottom of the new strip (left). r41 has it on the top (right), so every SMD part is on one side and JLC's Economic assembly applies. The op-amp now takes its feedback at the output pin, after R11, so the receiver's input doesn't shift the reading; R9 is 1206; the two M3 holes have no copper under a screw head; the jumpers are labelled TEST and 120R.

Before (r36): the stage on the bottom of the strip.

Before (r36): the stage on the bottom of the strip.

After (r41): the stage on the top, one-sided assembly.

After (r41): the stage on the top, one-sided assembly.

## Runs and open decisions

Each run regenerates and routes the whole board, then scores it: DRC against upstream's own errors, vias in pads, and checks/layout_review.py (noisy nets beside sensitive ones, return paths under tracks, ground pour). Decisions are yours; the default in use is listed.

ID | What | State | Result / default
r33 | Pull C17 toward the op-amp on the old small board (placement weight). | DONE | 6 open connections: reverted. Showed the small board was the limit.
r34 | Grow 15 mm, stage into the strip, add R11, keep all upstream tracks. | DONE | 0 new / 0 open first try. Layout review: CAN_L ran 0.3 mm beside the output for 6.8 mm.
r35 | Move the CAN terminator off the output's corridor. | DONE | Coupling clean (nothing within 1 mm). C17 still 6.1 mm from its pin.
r36 | Start C17/C15 on the right side of the chip; tie caps to their pins. | DONE | 0/0/0, no review flags; C17 2.1 mm, C15 2.3 mm. Current board.
D7 | Separate analog ground for J3-7 on the board (heater current shares the ground wires). | DONE | No board change (your decision). Bring-up test A4 measures the real ground offset.
D8 | Mounting holes in the new bottom corners for your enclosure. | DONE | Done r37: two M3 holes; r41 keeps copper 3.6 mm clear of them.
D9 | Put the analog stage on the top of the strip for one-sided (cheaper) JLC assembly. | DONE | Done r37: every SMD part on the top. Economic $8 setup vs $50 two-sided (JLC help, 2025-09).
D1 | R9 (op-amp supply resistor) 0603 to 1206 for long surges. | DONE | Done r37: R9 1k 1206 (C4410).
r37 | Stage to the top; feedback from J3-5 after R11; R9 1206; M3 holes. | DONE | 0 new DRC, 0 open; PWM return gap 4.1 mm (C7 cleared).
r38 | Merge same-net vias drilled too close; DRC check counts fab warnings. | DONE | Found a hole_to_hole pair hidden since about r26; fixed.
r39-r40 | Silkscreen at JLC minimum, labels only where they belong; fab export. | DONE | 11-12 labels, TEST and 120R on the jumpers; BOM 25 lines, CPL 38 parts.
JLC | Rotation, origin and pin names from each part's EasyEDA footprint. | DONE | 4 rotation fixes, U2 shifted 0.725 mm, D2 would have gone on backwards by pad number: fixed.
r41 | No copper under the screw heads. | DONE | Pour was 0.3 mm from the holes; now 3.6 mm.
D10 | Watchdog on the heater loop. | DONE | 0 B RAM, 5 host tests, bench self-test build W1.
Audit 4 | Codex audit of r41 (fork PR #1, merged). | DONE | 2 checker bugs (stack estimate, sim wrappers) fixed with regression tests; heater bug found in its unfinished second pass.
Heater | Hot sensor got up to 100 % heater (upstream code: negative voltage squared). | DONE | Voltage clamped at 0; host test HotterSensorNeverGetsMoreHeat.
Audit 5 | Outside review by your cousin's Claude. | DONE | BUG B1 (full lean for 0.8 s at power-up) fixed: R3 4.7k + PB1 pull-down, check boot_level.py, bench A5. N1: invalid now 5 V.
R1 | Full scale into a 4.7k receiver with the clamps and real supply (TI model, 27 cases). | DONE | 10k and up: +2 mV everywhere. 4.7k: -66 to -178 mV only when +5V sits at 4.8 V. Accepted; bench A7 measures +5V.
Module | Module (upstream rev C) order files and rotation check. | DONE | 2 parts out at JLC substituted (R10 61.9R, C3 33n). 56 of 57 rotations agree with upstream; Q1 heater switch would have gone on turned 180: fixed.
Stock | Live JLC stock and price for both BOMs (bom_stock.py). | DONE | All in stock; parts about $20 (carriers) + $57 (modules) for 5 each.
Audit 6 | Re-audit of the 2026-10-24 changes (Codex and/or your cousin). | TODO | Start at REVIEW.md; pack: sh checks/review_pack.sh.
Order | Programmer, bench gear, then the JLC order (your money calls). | TODO | ROADMAP.md shopping list; ordering.md for the quote; placement preview Q1 and D2 first.
