flyboy-byte/wideband-work/work/audit/codex-r41-2026-10-24/gerber-bottom.png

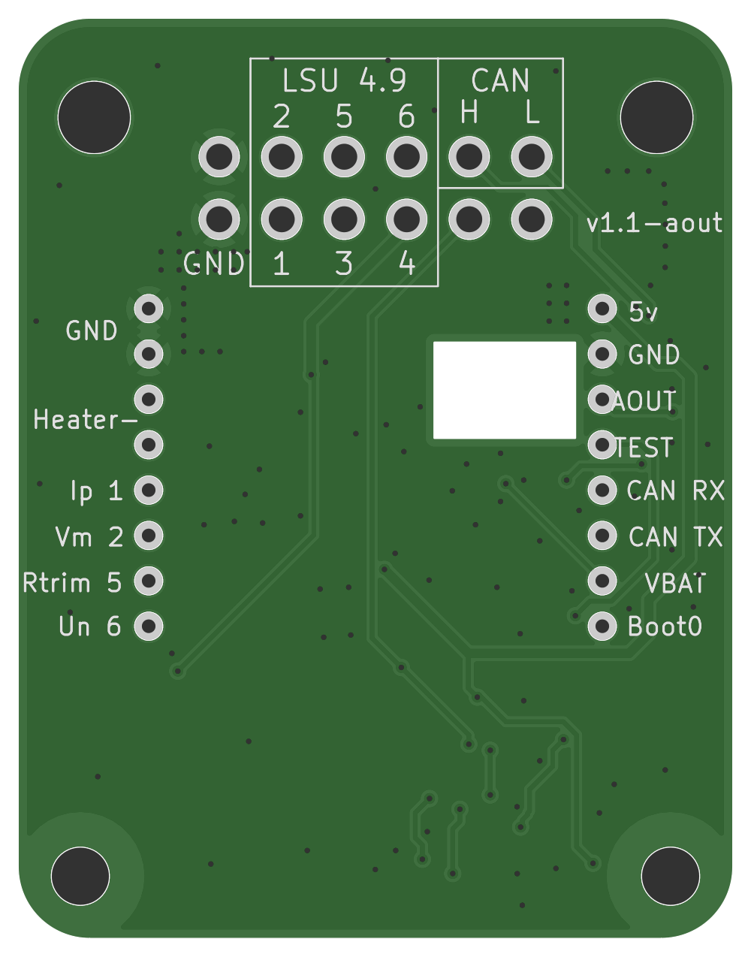
work/audit/codex-r41-2026-10-24/gerber-bottom.png
