flyboy-byte/wideband-work/work/audit/codex-r41-2026-10-24/gerber-top.png

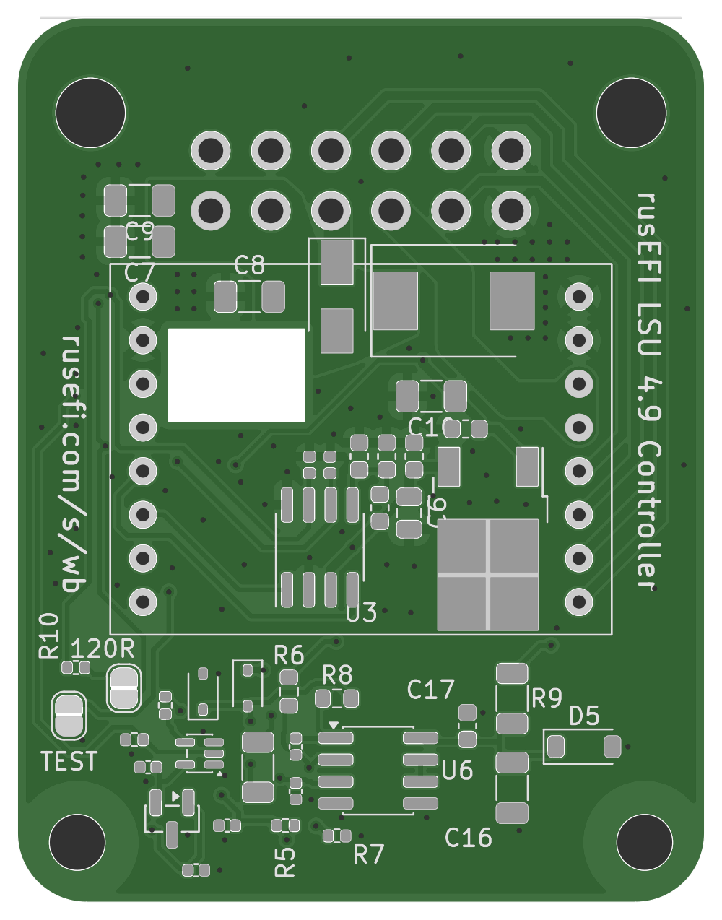
work/audit/codex-r41-2026-10-24/gerber-top.png
