flyboy-byte/wideband-work/work/renders/carrier-a/board_carrier.png

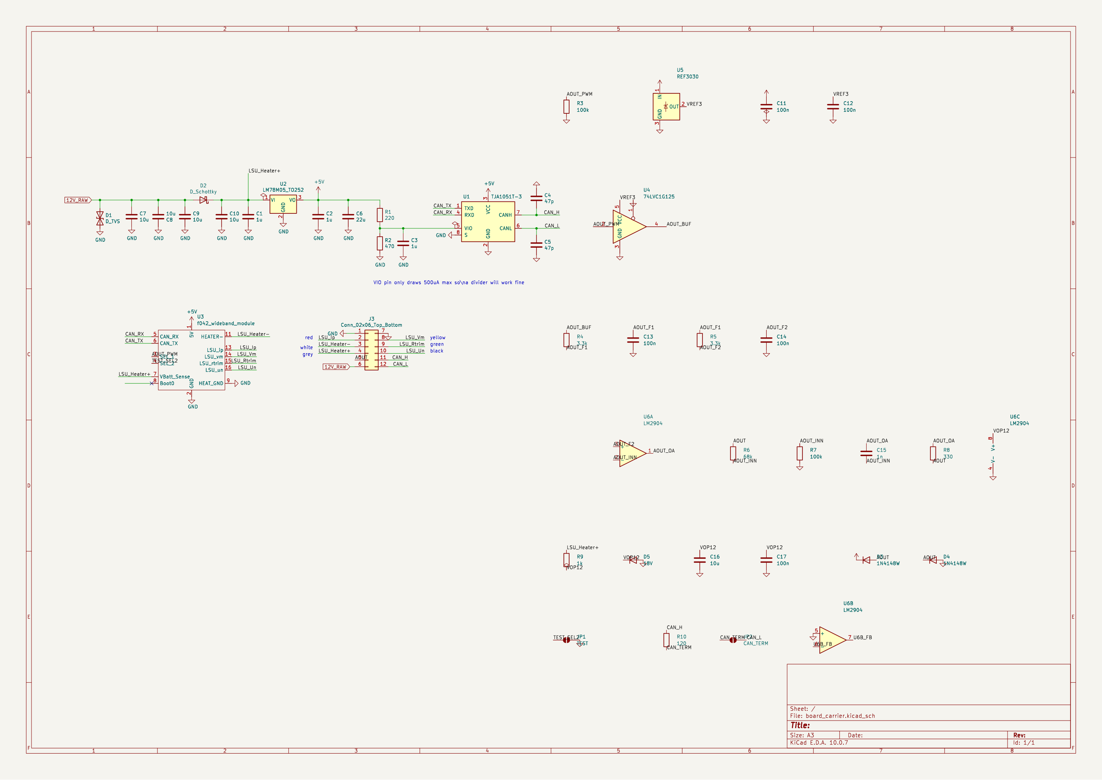
work/renders/carrier-a/board_carrier.png
