flyboy-byte/wideband-work/work/renders/carrier-a/place1_bottom.png

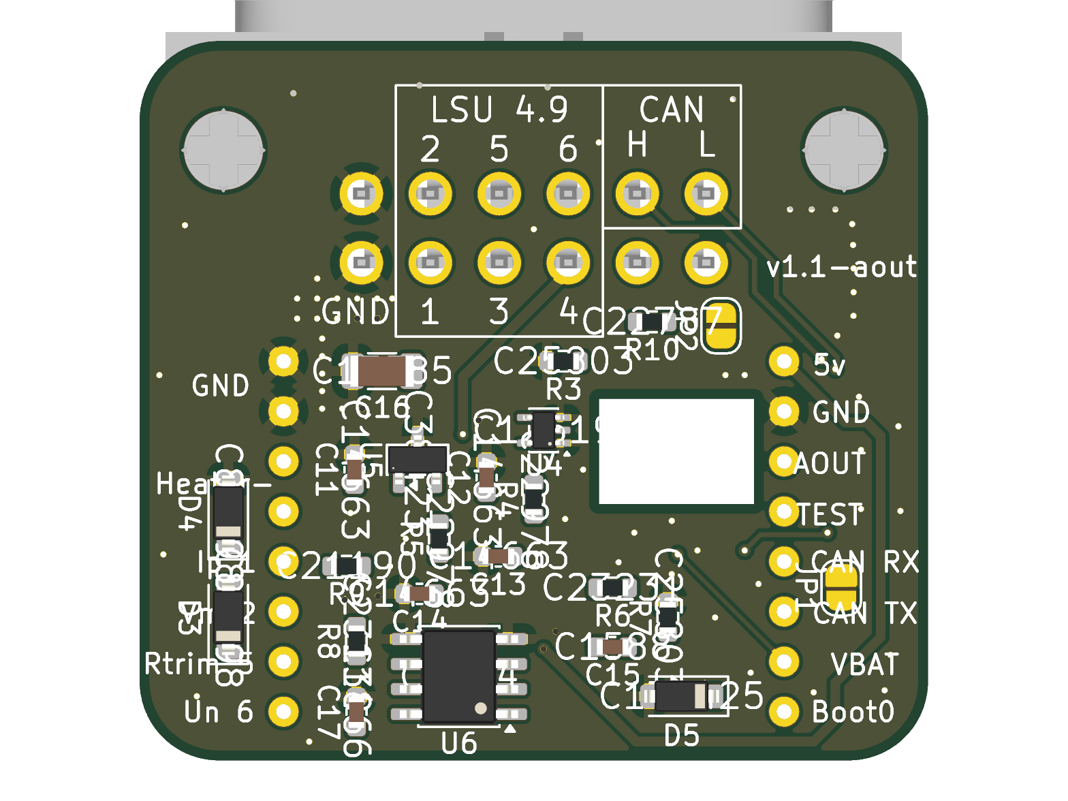
work/renders/carrier-a/place1_bottom.png
