flyboy-byte/wideband-work/work/renders/carrier-a/place3_bottom.png

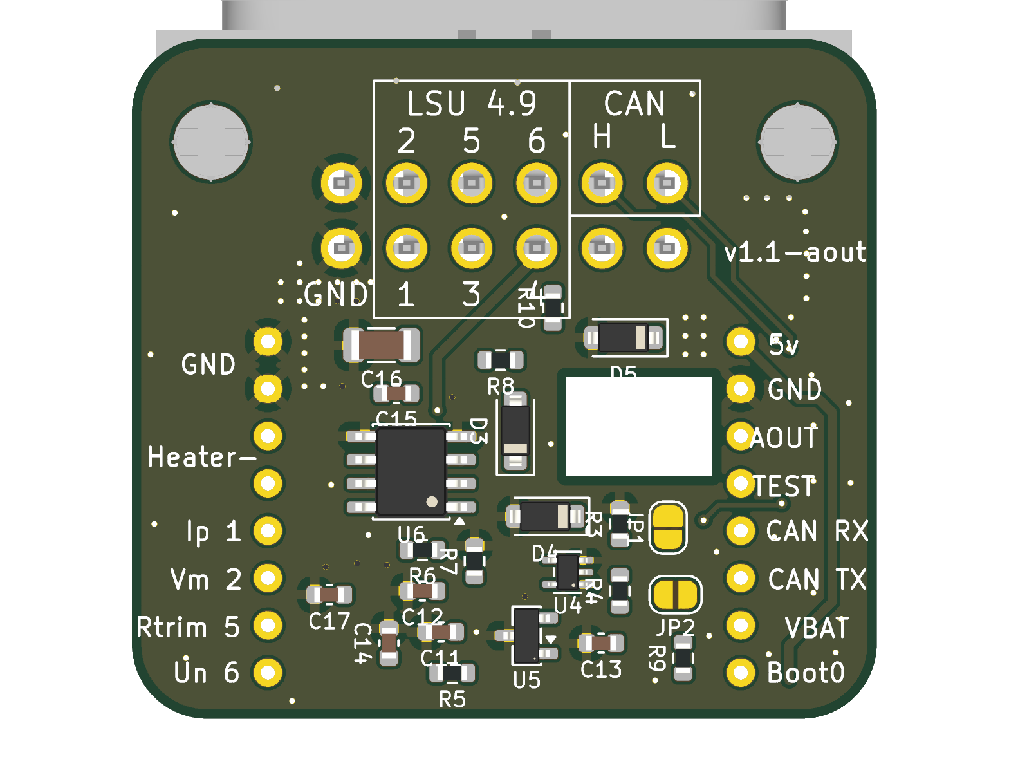
work/renders/carrier-a/place3_bottom.png
