flyboy-byte/wideband-work/work/renders/carrier-a/right.png

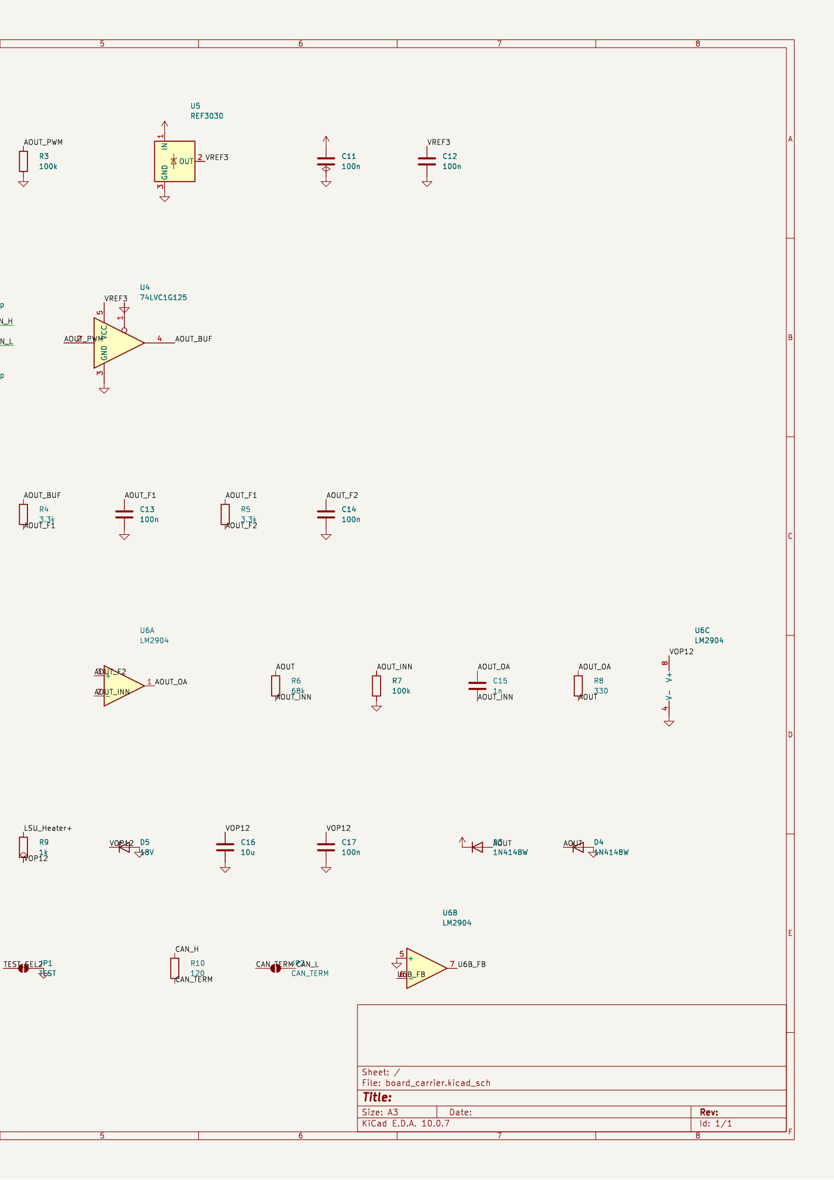
work/renders/carrier-a/right.png
