flyboy-byte/wideband-work/work/renders/carrier-a/upstream_bottom.png

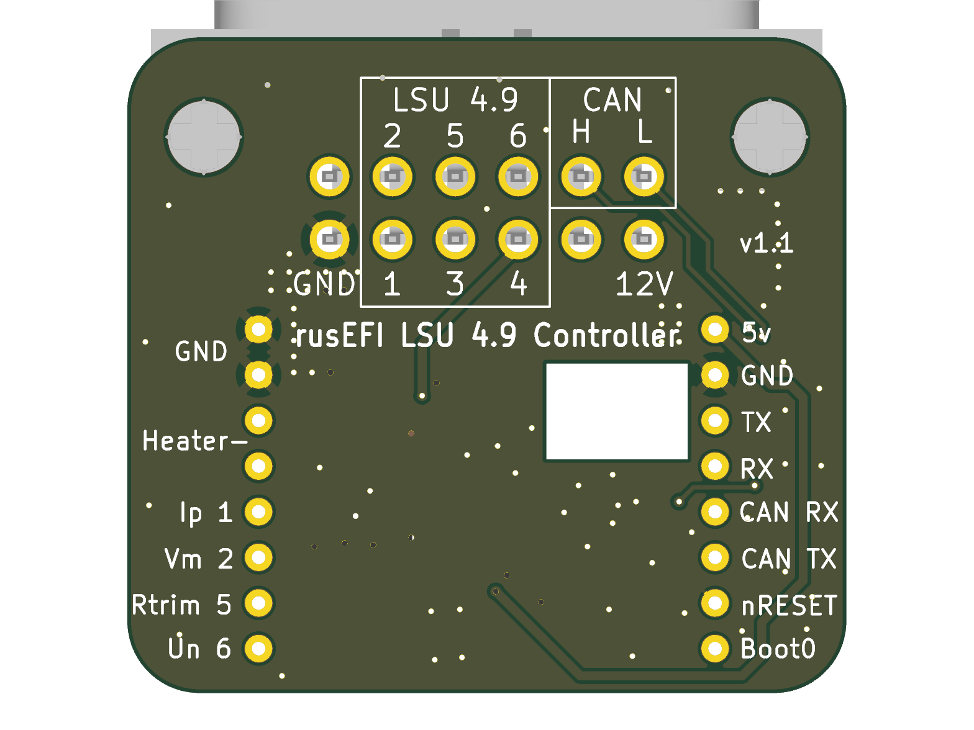
work/renders/carrier-a/upstream_bottom.png
