flyboy-byte/wideband-work/work/renders/carrier-a/upstream_top.png

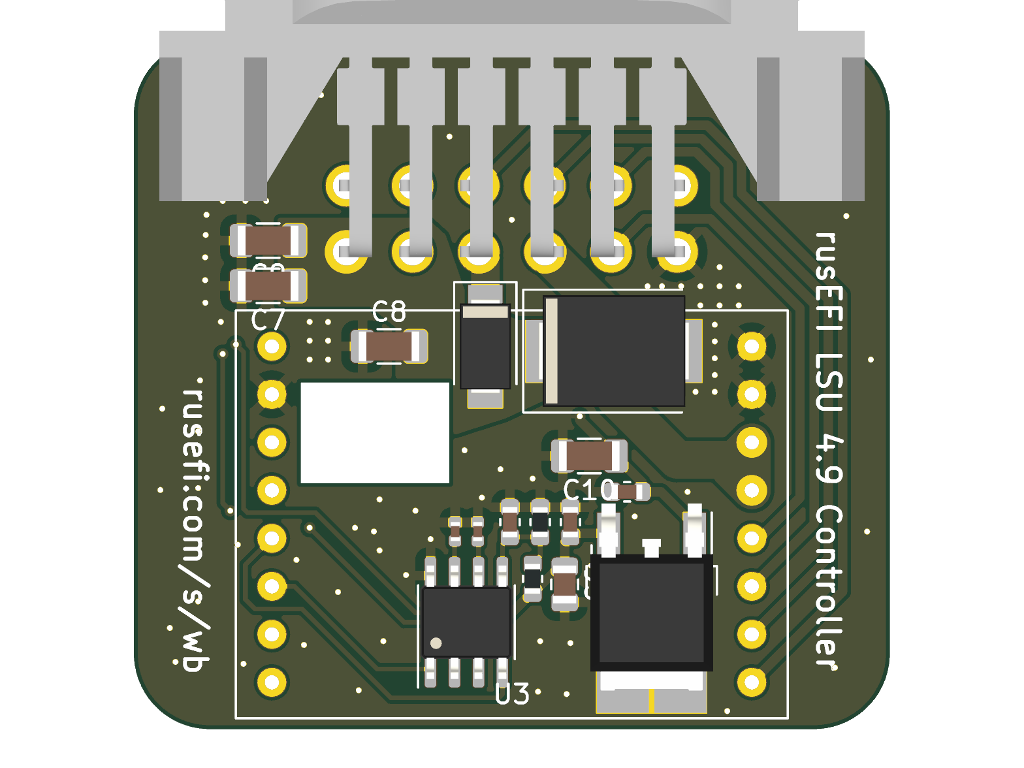
work/renders/carrier-a/upstream_top.png
