flyboy-byte/wideband-work/work/renders/carrier-c/bottom.png

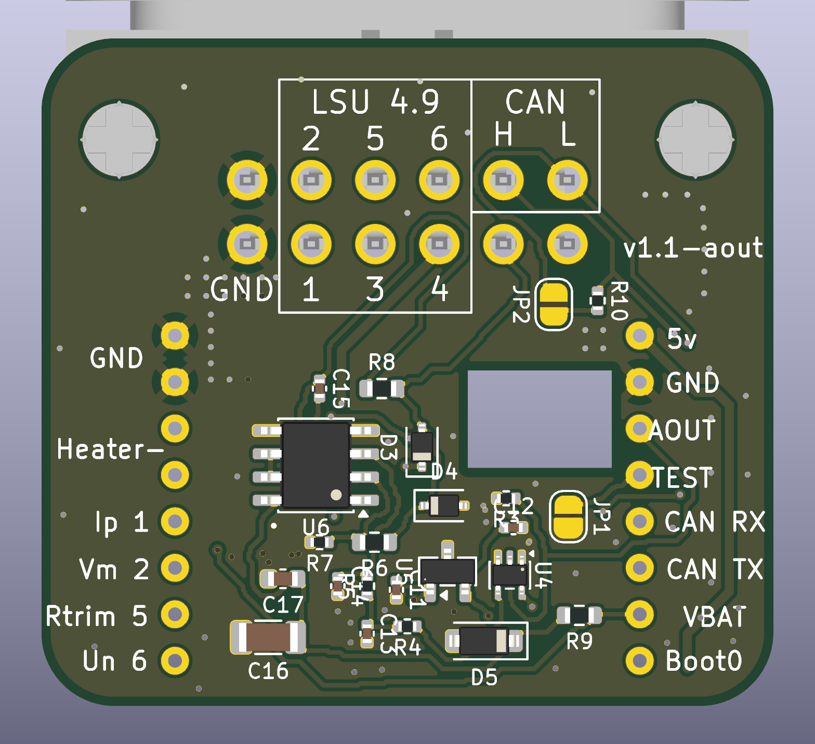
work/renders/carrier-c/bottom.png
