flyboy-byte/wideband-work/work/renders/carrier-c/top.png

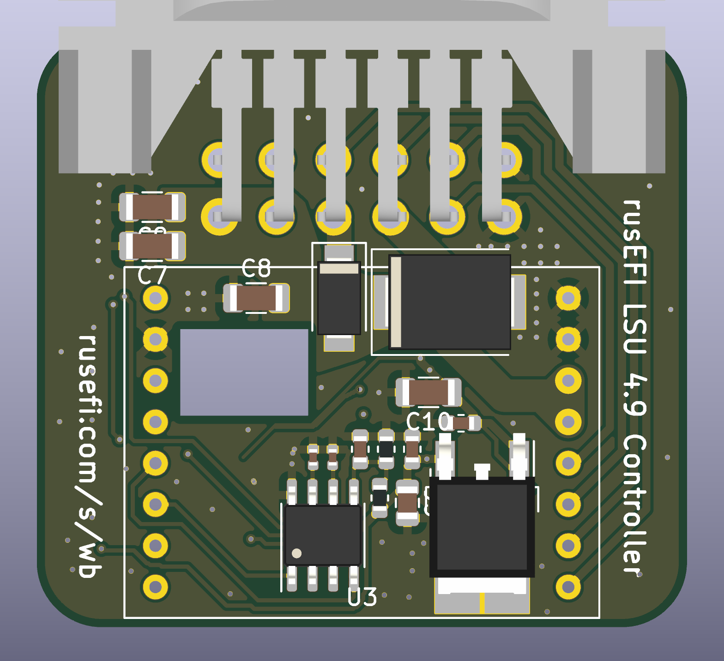
work/renders/carrier-c/top.png
