flyboy-byte/wideband-work/work/renders/carrier-c/zoom-bottom-cur.png

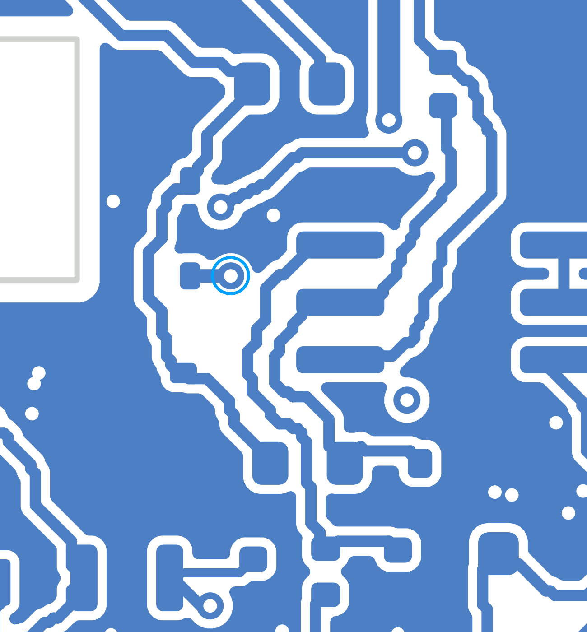
work/renders/carrier-c/zoom-bottom-cur.png
