flyboy-byte/wideband-work/work/renders/carrier-c/zoom-top-cur.png

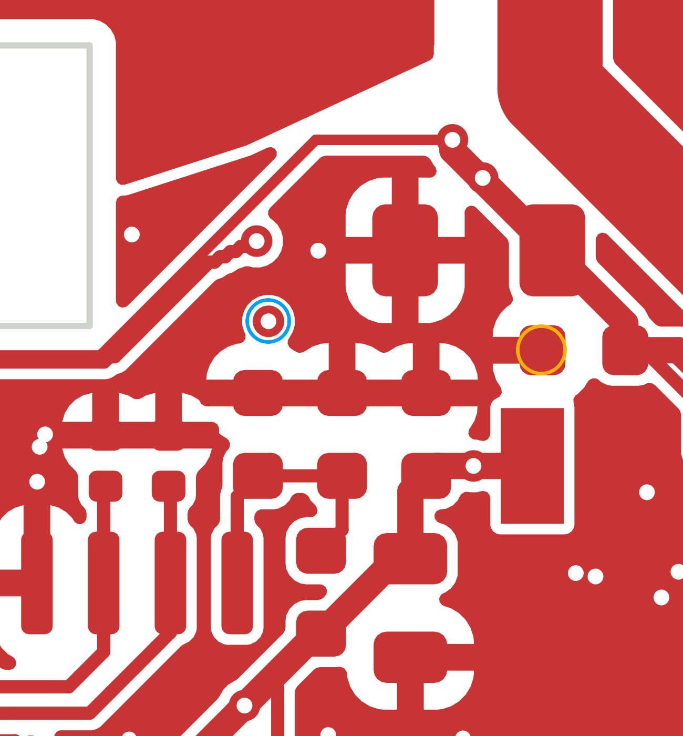
work/renders/carrier-c/zoom-top-cur.png
