flyboy-byte/wideband-work/work/renders/carrier-d/zoom-top-fixed.png

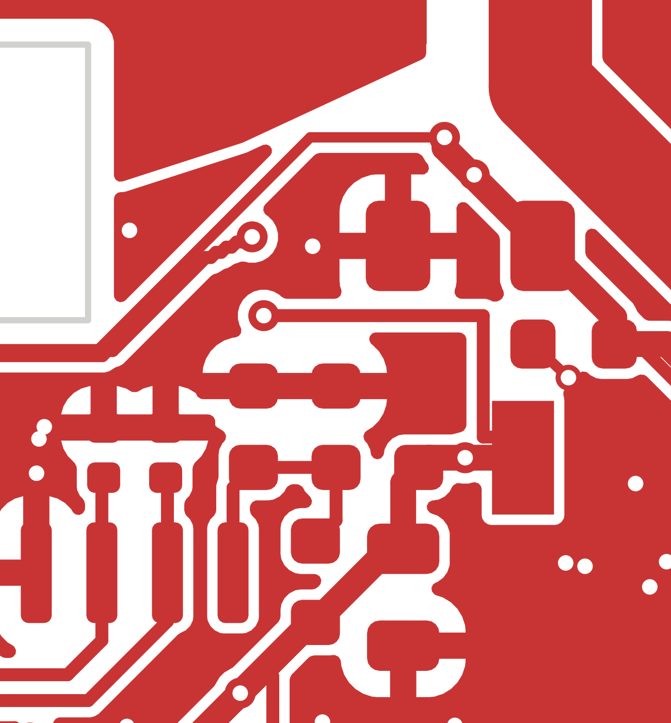
work/renders/carrier-d/zoom-top-fixed.png
