flyboy-byte/wideband-work/work/renders/carrier-f/bottom.png

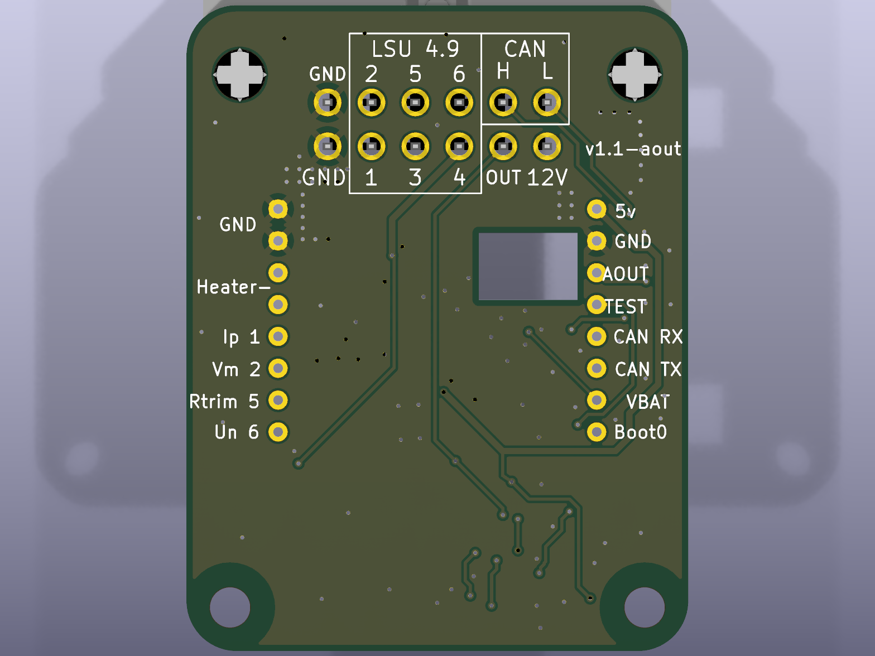
work/renders/carrier-f/bottom.png
