flyboy-byte/wideband-work/work/renders/carrier-f/iso-back.png

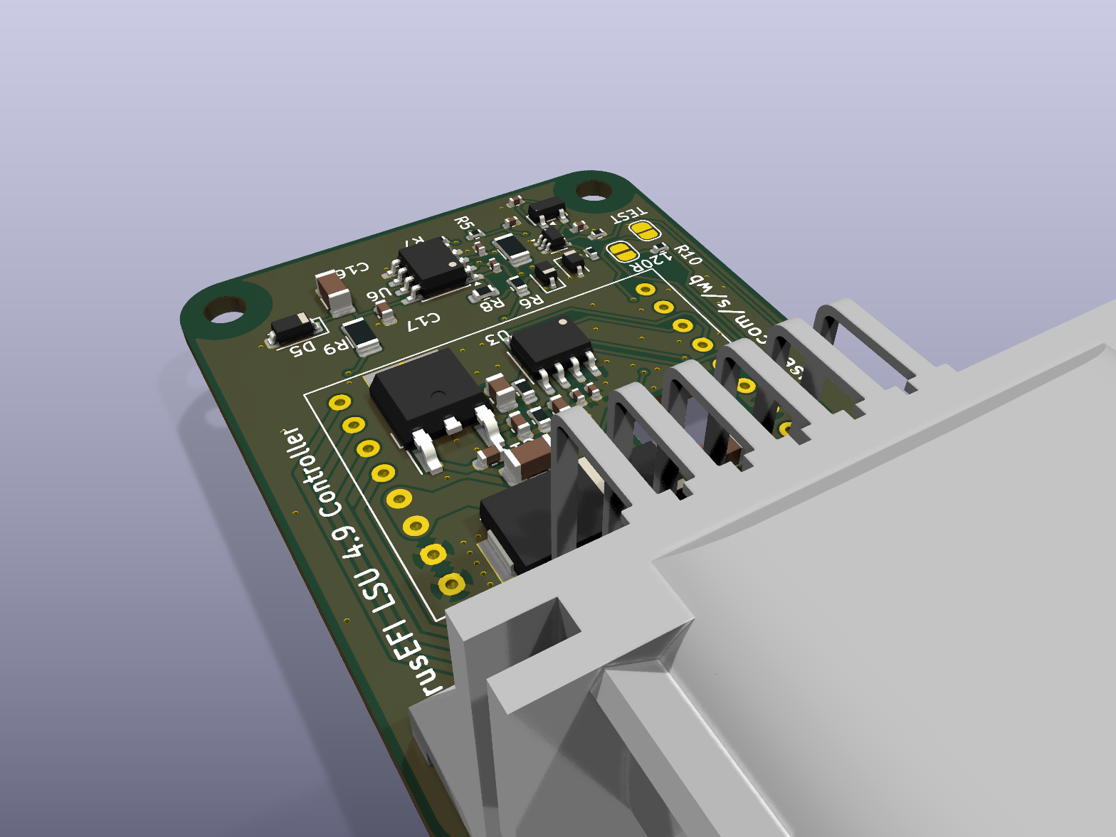
work/renders/carrier-f/iso-back.png
