flyboy-byte/wideband-work/work/renders/carrier-f/iso-bottom.png

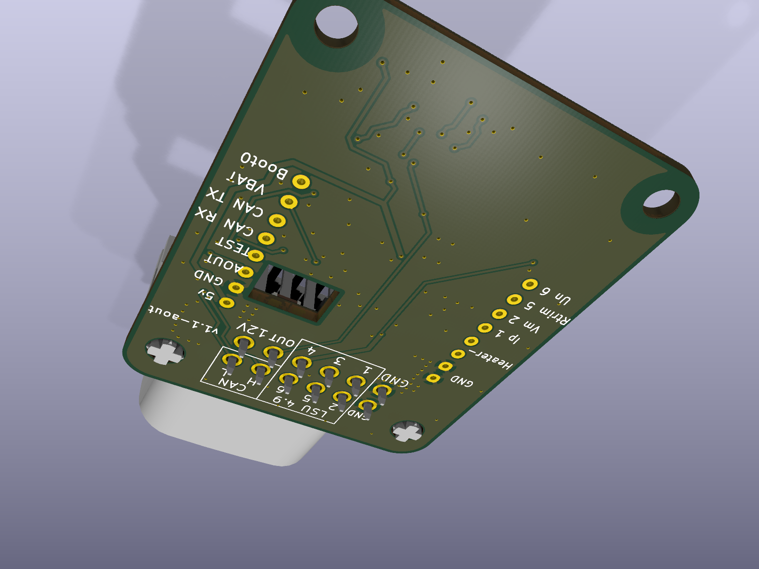
work/renders/carrier-f/iso-bottom.png
