flyboy-byte/wideband-work/work/renders/carrier-f/iso-front.png

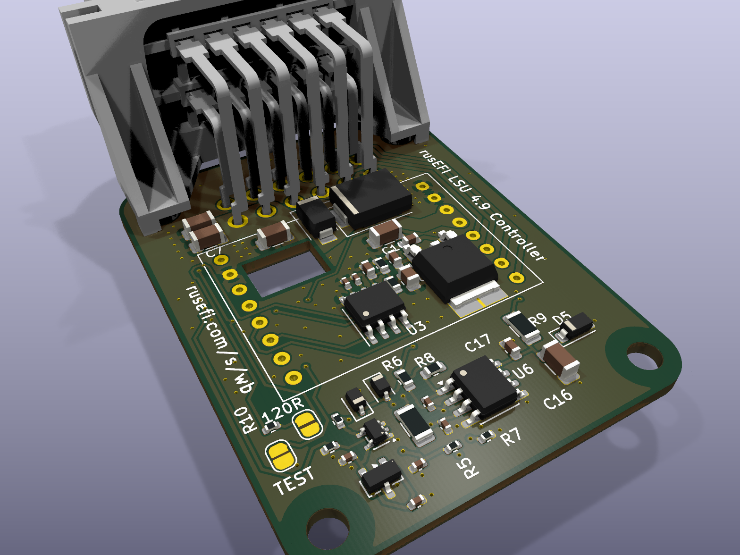
work/renders/carrier-f/iso-front.png
