flyboy-byte/wideband-work/work/renders/module/swd-pads.png

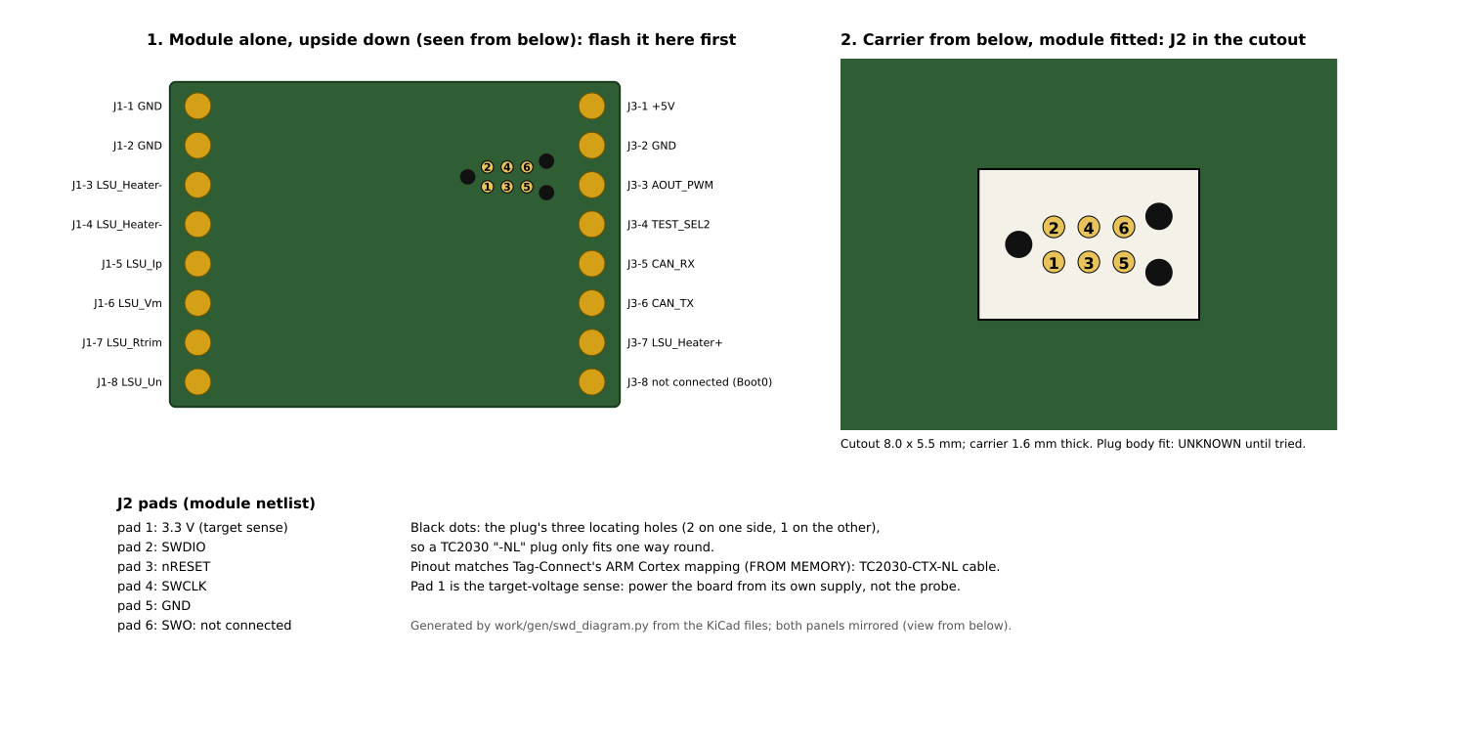
work/renders/module/swd-pads.png
