flyboy-byte/wideband-work/work/fab/flyboy-o2-v1/carrier-bom.csv

Comment | Designator | Footprint | LCSC Part #
1u | C1,C2,C3 | C_0603_1608Metric | C15849
47p | C4,C5 | C_0402_1005Metric | C1567
22u | C6 | C_0805_2012Metric | C45783
10u | C7,C8,C9,C10,C16 | C_1206_3216Metric | C13585
100n | C11,C12,C13,C14 | C_0402_1005Metric | C1525
1n | C15 | C_0402_1005Metric | C1523
100n | C17 | C_0603_1608Metric | C14663
D_TVS | D1 | D_SMC | C151279
D_Schottky | D2 | D_SMA | C22452
1N4148WS | D3,D4 | D_SOD-323 | C2128
18V | D5 | D_SOD-123 | C173425
220 | R1 | R_0603_1608Metric | C22962
470 | R2 | R_0603_1608Metric | C23179
4.7k | R3 | R_0402_1005Metric | C25900
3.3k | R4,R5 | R_0402_1005Metric | C25890
68k | R6 | R_0603_1608Metric | C23231
100k | R7 | R_0402_1005Metric | C25741
330 | R8 | R_0603_1608Metric | C23138
1k | R9 | R_1206_3216Metric | C844867
120 | R10 | R_0402_1005Metric | C25079
470 | R11 | R_1206_3216Metric | C4502
TJA1051T-3 | U1 | SOIC-8_3.9x4.9mm_P1.27mm | C38695
LM78M05_TO252 | U2 | TO-252-2 | C58069
74LVC1G125 | U4 | SOT-353_SC-70-5 | C12519
REF3030 | U5 | SOT-23 | C38423
LM2904 | U6 | SOIC-8_3.9x4.9mm_P1.27mm | C7934
