flyboy-byte/wideband-work/work/audit/claude-sidewinderzz-2026-10-24/clamp-results.txt

Vbat  13.8  +5V 5.0  25 C  drop 1.5  load 4.7k   target 5.00 V -> J3-5 5.000 V  (op-amp out 5.94 V, VOP12 11.37 V, D3 0.19 mA)
Vbat  13.8  +5V 5.0  25 C  drop 1.5  load 10k    target 5.00 V -> J3-5 5.000 V  (op-amp out 5.42 V, VOP12 12.12 V, D3 0.00 mA)
Vbat  13.8  +5V 5.0  25 C  drop 1.5  load 100k   target 5.00 V -> J3-5 5.000 V  (op-amp out 5.06 V, VOP12 12.57 V, D3 0.00 mA)
Vbat  12.0  +5V 5.0  25 C  drop 1.5  load 4.7k   target 5.00 V -> J3-5 5.000 V  (op-amp out 5.94 V, VOP12 9.57 V, D3 0.19 mA)
Vbat  12.0  +5V 5.0  25 C  drop 1.5  load 10k    target 5.00 V -> J3-5 5.000 V  (op-amp out 5.42 V, VOP12 10.32 V, D3 0.00 mA)
Vbat  12.0  +5V 5.0  25 C  drop 1.5  load 100k   target 5.00 V -> J3-5 5.000 V  (op-amp out 5.06 V, VOP12 10.77 V, D3 0.00 mA)
Vbat  13.8  +5V 4.8  25 C  drop 1.5  load 4.7k   target 5.00 V -> J3-5 4.935 V  (op-amp out 6.86 V, VOP12 8.36 V, D3 3.21 mA)
Vbat  13.8  +5V 4.8  25 C  drop 1.5  load 10k    target 5.00 V -> J3-5 5.000 V  (op-amp out 5.44 V, VOP12 12.07 V, D3 0.05 mA)
Vbat  13.8  +5V 4.8  25 C  drop 1.5  load 100k   target 5.00 V -> J3-5 5.000 V  (op-amp out 5.06 V, VOP12 12.57 V, D3 0.00 mA)
Vbat  12.0  +5V 4.8  25 C  drop 1.5  load 4.7k   target 5.00 V -> J3-5 4.913 V  (op-amp out 6.39 V, VOP12 7.89 V, D3 1.88 mA)
Vbat  12.0  +5V 4.8  25 C  drop 1.5  load 10k    target 5.00 V -> J3-5 5.000 V  (op-amp out 5.44 V, VOP12 10.27 V, D3 0.05 mA)
Vbat  12.0  +5V 4.8  25 C  drop 1.5  load 100k   target 5.00 V -> J3-5 5.000 V  (op-amp out 5.06 V, VOP12 10.77 V, D3 0.00 mA)
Vbat  13.8  +5V 5.0  85 C  drop 1.5  load 4.7k   target 5.00 V -> J3-5 5.000 V  (op-amp out 6.65 V, VOP12 9.20 V, D3 2.36 mA)
Vbat  13.8  +5V 5.0  85 C  drop 1.5  load 10k    target 5.00 V -> J3-5 5.000 V  (op-amp out 5.43 V, VOP12 12.10 V, D3 0.02 mA)
Vbat  13.8  +5V 5.0  85 C  drop 1.5  load 100k   target 5.00 V -> J3-5 5.000 V  (op-amp out 5.06 V, VOP12 12.57 V, D3 0.00 mA)
Vbat  12.0  +5V 5.0  85 C  drop 1.5  load 4.7k   target 5.00 V -> J3-5 4.987 V  (op-amp out 6.45 V, VOP12 7.95 V, D3 1.80 mA)
Vbat  12.0  +5V 5.0  85 C  drop 1.5  load 10k    target 5.00 V -> J3-5 5.000 V  (op-amp out 5.43 V, VOP12 10.30 V, D3 0.02 mA)
Vbat  12.0  +5V 5.0  85 C  drop 1.5  load 100k   target 5.00 V -> J3-5 5.000 V  (op-amp out 5.06 V, VOP12 10.77 V, D3 0.00 mA)
Vbat  13.8  +5V 4.8  85 C  drop 1.5  load 4.7k   target 5.00 V -> J3-5 4.836 V  (op-amp out 6.78 V, VOP12 8.28 V, D3 3.32 mA)
Vbat  13.8  +5V 4.8  85 C  drop 1.5  load 10k    target 5.00 V -> J3-5 5.000 V  (op-amp out 5.66 V, VOP12 11.40 V, D3 0.72 mA)
Vbat  13.8  +5V 4.8  85 C  drop 1.5  load 100k   target 5.00 V -> J3-5 5.000 V  (op-amp out 5.07 V, VOP12 12.56 V, D3 0.01 mA)
Vbat  12.0  +5V 4.8  85 C  drop 1.5  load 4.7k   target 5.00 V -> J3-5 4.810 V  (op-amp out 6.31 V, VOP12 7.81 V, D3 1.99 mA)
Vbat  12.0  +5V 4.8  85 C  drop 1.5  load 10k    target 5.00 V -> J3-5 5.000 V  (op-amp out 5.66 V, VOP12 9.60 V, D3 0.72 mA)
Vbat  12.0  +5V 4.8  85 C  drop 1.5  load 100k   target 5.00 V -> J3-5 5.000 V  (op-amp out 5.07 V, VOP12 10.76 V, D3 0.01 mA)
