flyboy-byte/wideband-work/work/audit/codex-r41-2026-10-24/sim-failure.txt

stability.sh: simulator always exits 1; wrapper exits 1
A  Cload=1p   Cf=-     before 0.0000 V  after 0.0000 V  peak 0.0000 V  overshoot    0.0 %  ripple at end   0.00 mV  settles (1%)     0 us
A  Cload=1n   Cf=-     before 0.0000 V  after 0.0000 V  peak 0.0000 V  overshoot    0.0 %  ripple at end   0.00 mV  settles (1%)     0 us
A  Cload=10n  Cf=-     before 0.0000 V  after 0.0000 V  peak 0.0000 V  overshoot    0.0 %  ripple at end   0.00 mV  settles (1%)     0 us
A  Cload=47n  Cf=-     before 0.0000 V  after 0.0000 V  peak 0.0000 V  overshoot    0.0 %  ripple at end   0.00 mV  settles (1%)     0 us
B  Cload=1p   Cf=-     before 0.0000 V  after 0.0000 V  peak 0.0000 V  overshoot    0.0 %  ripple at end   0.00 mV  settles (1%)     0 us
B  Cload=1n   Cf=-     before 0.0000 V  after 0.0000 V  peak 0.0000 V  overshoot    0.0 %  ripple at end   0.00 mV  settles (1%)     0 us
B  Cload=10n  Cf=-     before 0.0000 V  after 0.0000 V  peak 0.0000 V  overshoot    0.0 %  ripple at end   0.00 mV  settles (1%)     0 us
B  Cload=47n  Cf=-     before 0.0000 V  after 0.0000 V  peak 0.0000 V  overshoot    0.0 %  ripple at end   0.00 mV  settles (1%)     0 us
C  Cload=1p   Cf=100p  before 0.0000 V  after 0.0000 V  peak 0.0000 V  overshoot    0.0 %  ripple at end   0.00 mV  settles (1%)     0 us
C  Cload=1n   Cf=100p  before 0.0000 V  after 0.0000 V  peak 0.0000 V  overshoot    0.0 %  ripple at end   0.00 mV  settles (1%)     0 us
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
E  target 2.500 V  conn v5 4.7k     ->  V
E  target 5.000 V  conn 0 100k      ->  V
E  target 5.000 V  conn 0 10k       ->  V
E  target 5.000 V  conn 0 4.7k      ->  V
E  target 5.000 V  conn v5 47k      ->  V
E  target 5.000 V  conn v5 10k      ->  V
E  target 5.000 V  conn v5 4.7k     ->  V
