flyboy-byte/wideband-work/(list of files, drawings)

Other design files:
work/checks/easyeda/C1523.json
work/checks/easyeda/C1525.json
work/checks/easyeda/C1567.json
work/checks/easyeda/C2128.json
work/checks/easyeda/C2286.json
work/checks/easyeda/C2288.json
work/checks/easyeda/C4410.json
work/checks/easyeda/C4502.json
work/checks/easyeda/C5446.json
work/checks/easyeda/C7934.json
work/checks/easyeda/C8678.json
work/checks/easyeda/C11702.json
work/checks/easyeda/C12519.json
work/checks/easyeda/C12624.json
work/checks/easyeda/C13585.json
work/checks/easyeda/C14663.json
work/checks/easyeda/C15849.json
work/checks/easyeda/C19666.json
work/checks/easyeda/C22452.json
work/checks/easyeda/C22962.json
work/checks/easyeda/C23138.json
work/checks/easyeda/C23179.json
work/checks/easyeda/C23221.json
work/checks/easyeda/C23231.json
work/checks/easyeda/C25077.json
work/checks/easyeda/C25079.json
work/checks/easyeda/C25118.json
work/checks/easyeda/C25741.json
work/checks/easyeda/C25744.json
work/checks/easyeda/C25768.json
work/checks/easyeda/C25771.json
work/checks/easyeda/C25792.json
work/checks/easyeda/C25890.json
work/checks/easyeda/C25900.json
work/checks/easyeda/C25917.json
work/checks/easyeda/C29309.json
work/checks/easyeda/C36658.json
work/checks/easyeda/C36871.json
work/checks/easyeda/C38423.json
work/checks/easyeda/C38695.json
work/checks/easyeda/C45783.json
work/checks/easyeda/C50282.json
work/checks/easyeda/C52923.json
work/checks/easyeda/C58069.json
work/checks/easyeda/C69216.json
work/checks/easyeda/C106862.json
work/checks/easyeda/C133648.json
work/checks/easyeda/C151279.json
work/checks/easyeda/C173425.json
work/checks/easyeda/C844867.json
work/checks/easyeda/C2087389.json
work/checks/easyeda/C2649436.json
