flyboy-byte/wideband-work/hardware/board_carrier/board_carrier.kicad_pcb

## KiCad design hardware/board_carrier/board_carrier.kicad_pcb (2026-10-25)

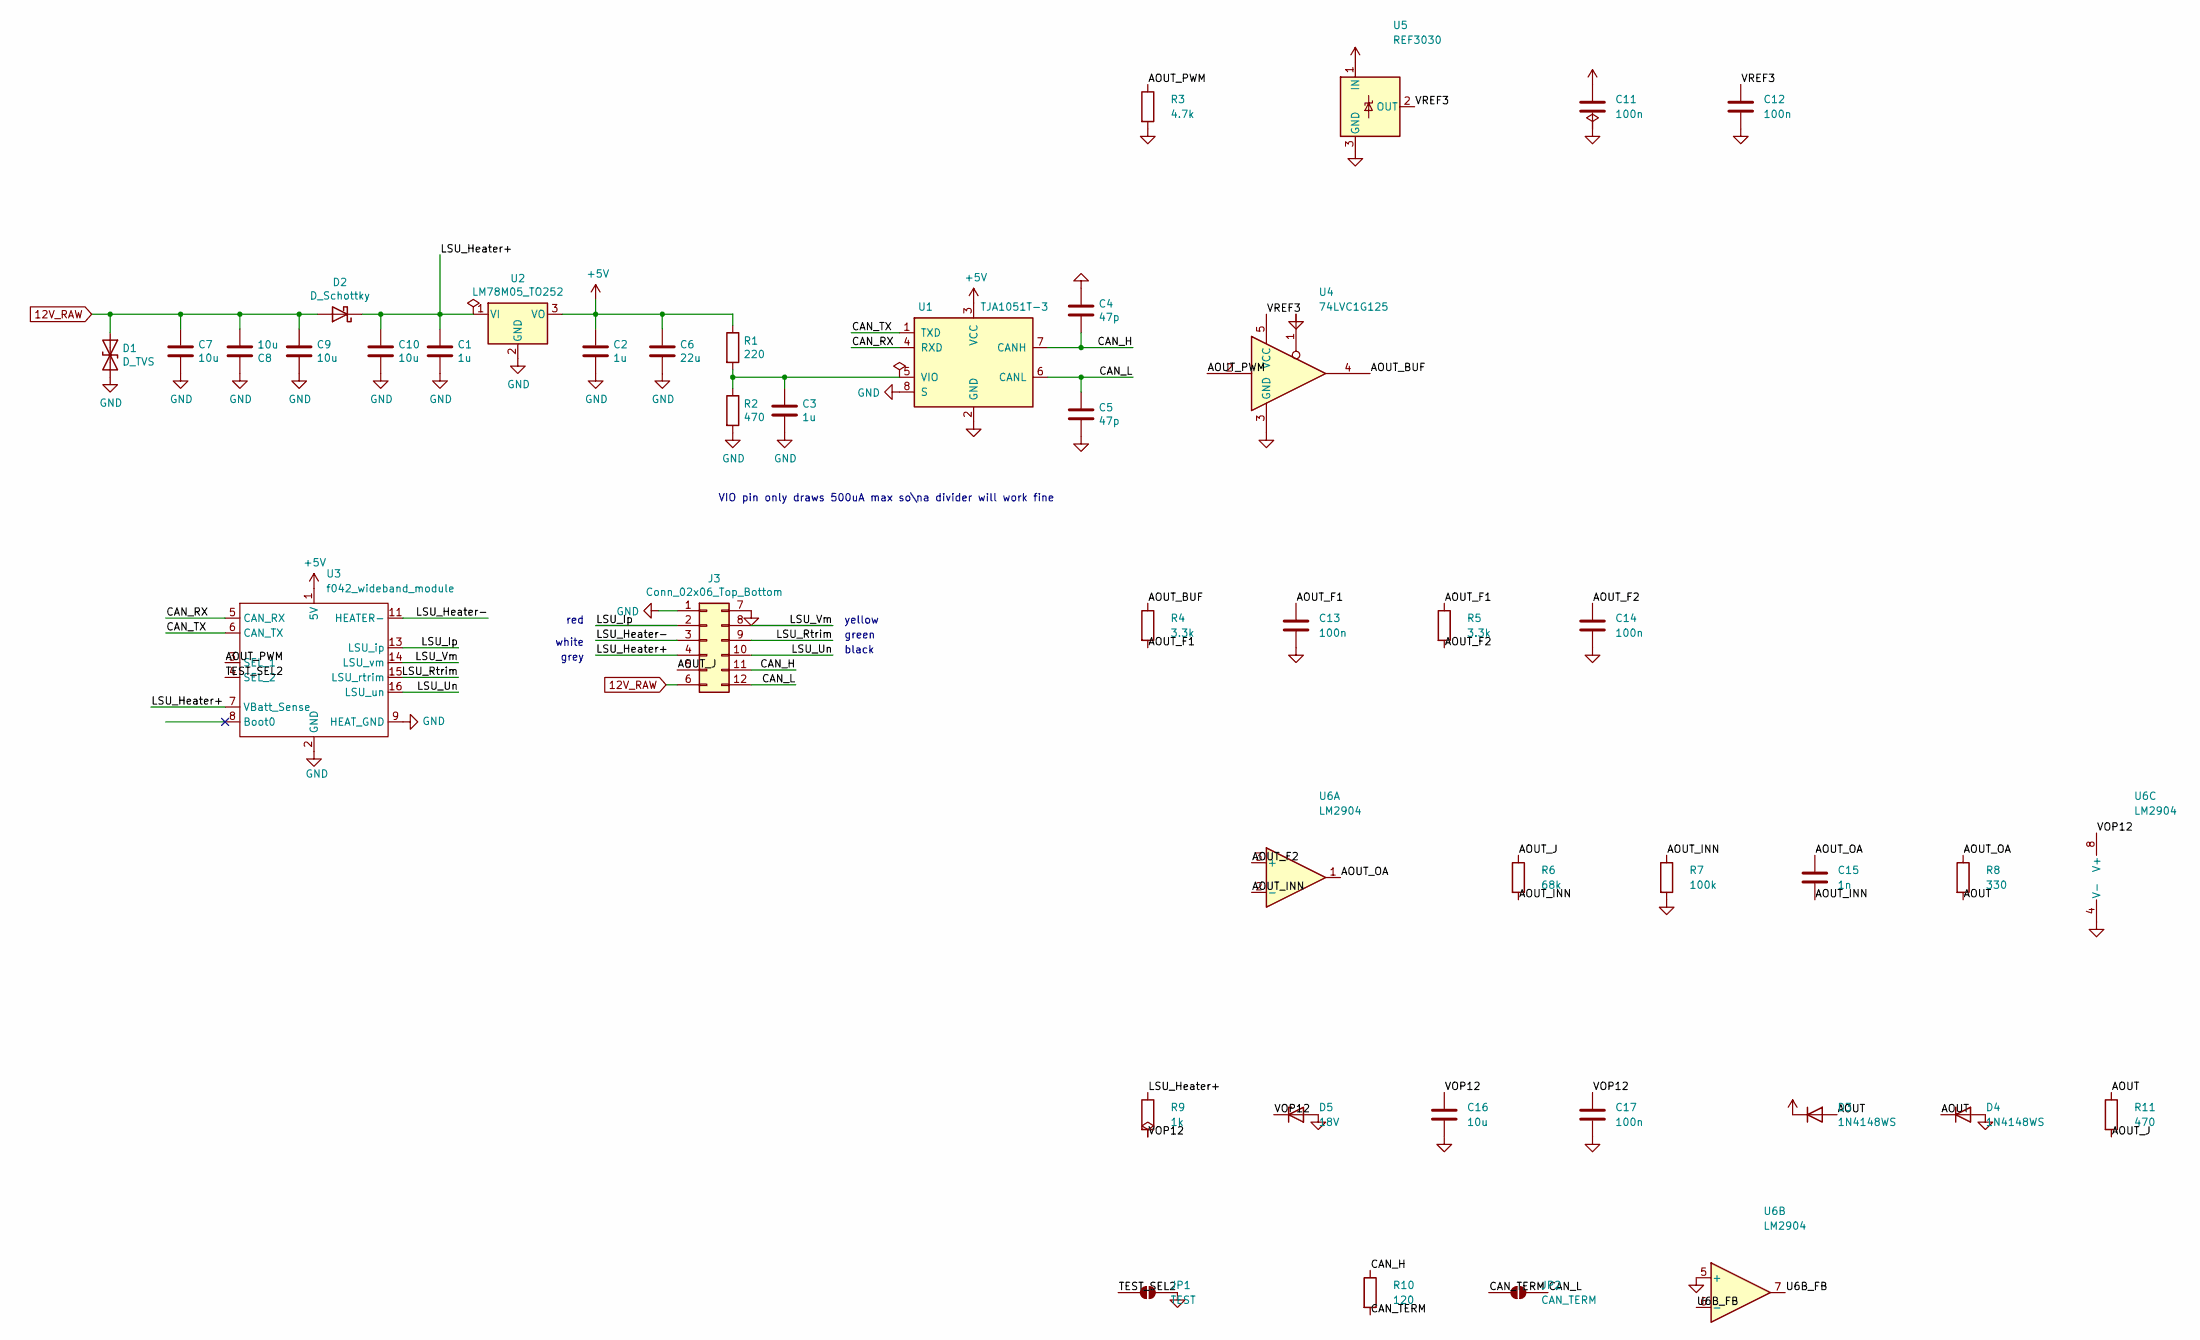
[picture p20: schematic board_carrier.kicad_sch]

Parts:
C1, C2, C3: 1u; C_0603_1608Metric; LCSC C15849
C4, C5: 47p; C_0402_1005Metric; LCSC C1567
C6: 22u; C_0805_2012Metric; LCSC C45783
C7, C8, C9, C10, C16: 10u; C_1206_3216Metric; LCSC C13585
C11, C12, C13, C14: 100n; C_0402_1005Metric; LCSC C1525
C15: 1n; C_0402_1005Metric; LCSC C1523
C17: 100n; C_0603_1608Metric; LCSC C14663
D1: D_TVS; D_SMC; LCSC C151279
D2: D_Schottky; D_SMA; LCSC C22452
D3, D4: 1N4148WS; D_SOD-323; LCSC C2128
D5: 18V; D_SOD-123; LCSC C173425
J3: Conn_02x06_Top_Bottom; mx120g-12
JP1: TEST; SolderJumper-2_P1.3mm_Open_RoundedPad1.0x1.5mm
JP2: CAN_TERM; SolderJumper-2_P1.3mm_Open_RoundedPad1.0x1.5mm
R1: 220; R_0603_1608Metric; LCSC C22962
R2: 470; R_0603_1608Metric; LCSC C23179
R3: 4.7k; R_0402_1005Metric; LCSC C25900
R4, R5: 3.3k; R_0402_1005Metric; LCSC C25890
R6: 68k; R_0603_1608Metric; LCSC C23231
R7: 100k; R_0402_1005Metric; LCSC C25741
R8: 330; R_0603_1608Metric; LCSC C23138
R9: 1k; R_1206_3216Metric; LCSC C844867
R10: 120; R_0402_1005Metric; LCSC C25079
R11: 470; R_1206_3216Metric; LCSC C4502
U1: TJA1051T-3; SOIC-8_3.9x4.9mm_P1.27mm; LCSC C38695
U2: LM78M05_TO252; TO-252-2; LCSC C58069
U3: f042_wideband_module
U4: 74LVC1G125; SOT-353_SC-70-5; LCSC C12519
U5: REF3030; SOT-23; LCSC C38423
U6: LM2904; SOIC-8_3.9x4.9mm_P1.27mm; LCSC C7934

Connections:
12V_RAW: C7.1, C8.2, C9.1, D1.1 (A1), D2.2 (A), J3.6
+5V: C2.1, C6.1, C11.1, D3.1 (K), R1.1, U1.3 (VCC), U2.3 (VO), U3.1 (5V), U5.1 (IN)
/AOUT: D3.2 (A), D4.1 (K), R8.2, R11.1
/AOUT_BUF: R4.1, U4.4
/AOUT_F1: C13.1, R4.2, R5.1
/AOUT_F2: C14.1, R5.2, U6.3 (+)
/AOUT_INN: C15.2, R6.2, R7.1, U6.2 (-)
/AOUT_J: J3.5, R6.1, R11.2
/AOUT_OA: C15.1, R8.1, U6.1
/AOUT_PWM: R3.1, U3.3 (SEL_1), U4.2
/CAN_H: C4.2, J3.11, R10.1, U1.7 (CANH)
/CAN_L: C5.1, J3.12, JP2.2 (B), U1.6 (CANL)
/CAN_RX: U1.4 (RXD), U3.5 (CAN_RX)
/CAN_TERM: JP2.1 (A), R10.2
/CAN_TX: U1.1 (TXD), U3.6 (CAN_TX)
/LSU_Heater+: C1.1, C10.1, D2.1 (K), J3.4, R9.1, U2.1 (VI), U3.7 (VBatt_Sense)
/LSU_Heater-: J3.3, U3.11 (HEATER-), U3.12 (HEATER-)
/LSU_Ip: J3.2, U3.13 (LSU_ip)
/LSU_Rtrim: J3.9, U3.15 (LSU_rtrim)
/LSU_Un: J3.10, U3.16 (LSU_un)
/LSU_Vm: J3.8, U3.14 (LSU_vm)
/TEST_SEL2: JP1.1 (A), U3.4 (SEL_2)
/U6B_FB: U6.6 (-), U6.7
/VOP12: C16.1, C17.1, D5.1 (K), R9.2, U6.8 (V+)
/VREF3: C12.1, U4.5 (VCC), U5.2 (OUT)
GND: C1.2, C2.2, C3.2, C4.1, C5.2, C6.2, C7.2, C8.1, C9.2, C10.2, C11.2, C12.2, C13.2, C14.2, C16.2, C17.2, D1.2 (A2), D4.2 (A), D5.2 (A), J3.1, J3.7, JP1.2 (B), R2.2, R3.2, R7.2, U1.2 (GND), U1.8 (S), U2.2 (GND), U3.2 (GND), U3.9 (HEAT_GND), U3.10 (HEAT_GND2), U4.1, U4.3 (GND), U5.3 (GND), U6.4 (V-), U6.5 (+)
unnamed: C3.1, R1.2, R2.1, U1.5 (VIO)

Notes on the sheet:
yellow
green
red
black
white
VIO pin only draws 500uA max so\na divider will work fine
grey

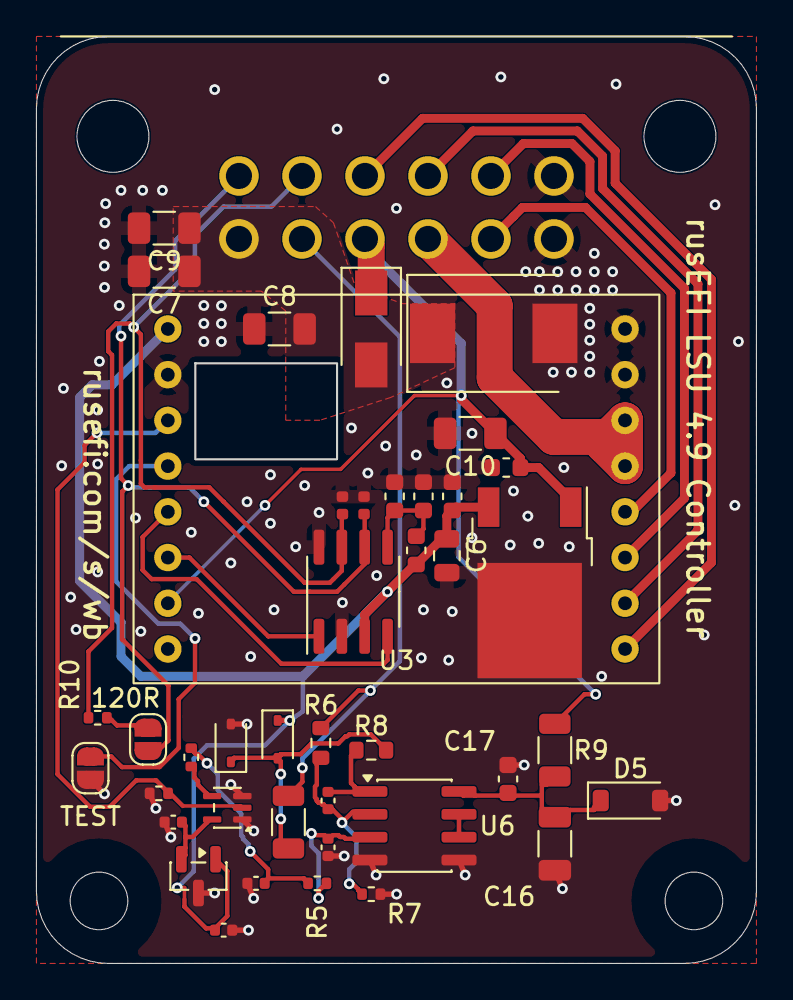
[picture p21: board board_carrier.kicad_pcb from above]

Board: 2 copper layers, 40.0 x 51.5 mm, 44 parts (0 on the bottom side), 27 nets.

Other parts of the board:
H1, H2: MountingHole_3.2mm_M3
