flyboy-byte/wideband-work/(commit log)

2026-10-23 wideband-work: pcb-design scaffold, checks on upstream module and carrier
    Claude-Session: https://claude.ai/code/session_01PSzkdckEqA8UiAsfxtaSyg
    [pinmap.csv]
2026-10-23 wideband-work: intent (build as is, then adapt), risk-probe plan
    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
2026-10-23 wideband-work: sensor choice LSU 4.9 with evidence tags
    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
2026-10-23 wideband-work: re-check of the analog-out plan (SEL pads are a CAN strap, PA8 shares the heater timer), AGENTS.md for subagents and Codex audits, design note, per-board check reports
    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
2026-10-23 wideband-work: weak points of the PB1 analog-out plan (accuracy, ground offset, coupling checked on layout)
    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
2026-10-23 wideband-work: lambda-x2 analog out is the same PWM-RC-op-amp circuit; propose copying it onto our carrier
    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
2026-10-23 wideband-work: carrier design draft (spare J3 pins, analog stage, receivers, firmware changes, draft tests); PB1 timer confirmed in KiCad library, f0 config already has aux fields
    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
2026-10-23 wideband-work: FlashPro facts from Hondata's help pages (analog only, 0 V=10:1 5 V=20:1, B29 on 2006-2011 Civic Si, G101 ground)
    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
2026-10-23 firmware: analog output on module pad SEL_1 (PB1, TIM3_CH4) for the f0 module, sharing the pump DAC timer, updated from the CAN TX thread; work: firmware notes, PB1 AF1 confirmed from ST pin data
    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
2026-10-23 work: carrier analog stage parts (REF3030, 74LVC1G125, LM2904, BAT54S) and ngspice filter simulation; firmware: full scale 5.04 V to match
    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
2026-10-23 work: STATE after the analog stage proposal
    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
2026-10-23 work: LM2904 stability simulation with TI's model; feedback after the series resistor oscillates with cable capacitance, dual loop with 1 nF does not
    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
2026-10-23 firmware: bench test mode on SEL_2 low (1.00/2.50/4.00 V steps) and compiled-in output trim; work: RAM now full, TEST jumper on the carrier, test A1 updated
    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
2026-10-23 board_carrier: schematic generated from code (upstream carrier + analog output, TEST jumper, CAN terminator, op-amp supply clamp); ERC clean, netlist self-check in checks
    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
    [board_carrier.kicad_sch]
2026-10-23 board_carrier: PCB generator (bottom-side analog stage, placer, Freerouting with upstream tracks locked) - work in progress, 3 nets unrouted
    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
    [board_carrier.kicad_pcb]
2026-10-23 work: drift snapshot includes the generated carrier PCB
    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
    [board_carrier.kicad_pcb]
2026-10-23 work: lessons sent to the pcb-design skill
    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
2026-10-23 board_carrier: annealing placer, GND fan-out and +5V tap vias, grid finisher after Freerouting, 0402 passives; 0 new DRC violations, 3 connections open (WIP)
    work: checks/drc_vs_upstream.py (DRC minus upstream's baseline, in run_all), HANDOFF.md replaced with run history r6-r16 and the last raw output, STATE updated, R8/R9 power rating flagged for the audit
    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
    [board_carrier.kicad_pcb, board_carrier.kicad_sch]
2026-10-23 work: lessons from the routing session (placer displacement, Freerouting log and stall, finisher, raw output in handoffs), sent to the skill
    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
2026-10-23 board_carrier: negotiated routing (PathFinder) of the analog stage's nets before Freerouting, GND pour pieces joined, vias kept out of SMD pads; 0 new DRC violations, 1 connection open (D3 to +5V)
    work: checks/via_in_pad.py in run_all
    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
    [board_carrier.kicad_pcb]
2026-10-24 work: root CLAUDE.md rewritten as full orientation for a new session (what this is, start steps, where it stands, commands, PCB pipeline, design, rules, owner, do-not-re-raise); AGENTS.md table adds 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
2026-10-24 board_carrier: last open connection closed (D3 +5V to U2 pin 3, C1 GND via, C2 solid pour) via close_d3_link in the generator; 0 new DRC violations, 0 open vs upstream, 0 new vias in pads
    work: whatif_route.py (candidate tracks scored on a scratch copy), report.py status page, audit hand-off in AUDIT.md, HANDOFF replaced, lessons, artifact-pipeline note; CLAUDE.md gains the gtest commands and the test-build quirk
    Claude-Session: https://claude.ai/code/session_013ZVt2aLpmrSY8uzxABcZfb
    [board_carrier.kicad_pcb]
2026-10-24 work: self-audit round 1 and RELEASE_ASSESSMENT (concept, audit path, about 75 % confidence, caveats, owner decisions D1-D5); firmware: CAN frame dropped instead of waiting 100 ms when the analog out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
    r33 (VOP12 placement weight to pull C17 in) tried and reverted: 6 open connections. Board unchanged from bf13162.
    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
    [can_helper.cpp]
2026-10-24 work: HANDOFF names the current audit pack (carrier-f)
    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
2026-10-24 work: Opus review of the self-audit (AUDIT round 2): 12 V on J3-5 back-feeds +5V through D3 (owner decision D6), GND-short and CAN-rate numbers corrected, authorship labels fixed; run_all skips KiCad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
    [run_all.py]
2026-10-24 work: owner designs his own enclosure; upstream case.STL is no longer a size limit (decision recorded)
    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
2026-10-24 work: CLAUDE.md no longer states the case size limit
    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
2026-10-24 board_carrier: board grown 15 mm (40.0 x 51.5 mm), analog stage in the new strip, R11 470R at J3-5 so a 12 V wiring fault can't back-feed +5V; 0 new DRC, 0 open, 0 vias in pads, 0 layout-review trigg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
    - gen_carrier_pcb: grow_board(), stage targets in the strip, upstream tracks all kept (REROUTE empty), bypass/Cf caps
    tied to their pins (C17 2.1 mm from U6 pin 8, was 4.5), CAN terminator moved off the output's corridor (r35)
    - checks/layout_review.py (new, in checks.json): coupling, return paths, GND pour, as numbers
    - sim/stability.sh topology D (R11): stable, 0.46 % low into 100k
    - AGENTS.md rules 7-8: no assumed engineering decisions; layout changes re-checked by measurement
    - do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
    [board_carrier.kicad_pcb, board_carrier.kicad_sch]
2026-10-24 work: status page rebuilt for r36 (grown board renders, before/after, runs r33-r36, open decisions D1/D7-D9)
    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
2026-10-24 work: audit circuit endpoints and fix order-dependent layout metrics
    Four ramped endpoint simulations complete; geometry and ordering regressions pass. Preserve PCB and firmware. Record open protection, load, grounding and PWM-return findings.
    [audit_analog.py, audit_layout_order.py, layout_metrics.py, layout_review.py, test_layout_metrics.py]
2026-10-24 work: scope flashing and test coverage; reproduce bootloader bounds bug
    Fresh isolated host build passes 43 tests with leak checking disabled. Add 48-case production-guard harness, flashing/test handoff, and explicit hardware/emulation limits. No board or production firmware changes.
    [audit_bootloader_bounds.py]
2026-10-24 firmware: f0 bootloader rejects CAN DATA writes outside the 25 KiB app partition (Codex F1); bounds from the linker script
    The guard allowed offsets up to 26 KiB and never checked offset + length, so updater frames could write the config page
    at 0x08007C00 or cross the end of flash. New bootloader_bounds.h IsAppWriteAllowed(): length <= 8, word-aligned, offset
    <= appSize, length <= appSize - offset. appFlashSize is the address of __appflash_size__ (0x6400 in the built ELF).
    Protocol unchanged: zero-length frames still ACK with no write; refused frames still get the (empty) NAK.
    Tests: audit_bootloader_bounds.py (Codex's harness, moved to the new call site) 52 cases, 0 unsafe, 0 valid refuse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
2026-10-24 work: F2 firmware package staging and validator; bad packages rejected (21 cases), upstream's shipped image passes
    fw_package.py build stages upstream's package format (app+CRC 25600 B, bootloader+app 31744 B, xxd header) into
    work/fw-build/<commit>/ without build_wideband.sh's deletes or the tracked for_rusefi/ overwrite, with a manifest.
    fw_package.py check: sizes, CRC via the bootloader's own isAppValid() compiled on the host and via zlib, Cortex-M0 vector
    tables, no config page. Two builds in different directories are byte-identical. F1 and F2 checks added to run_all.
    Claude-Session: https://claude.ai/code/session_013ZVt2aLpmrSY8uz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
2026-10-24 firmware: HardFault entry in ARMv6-M instructions so a fault on the f0's Cortex-M0 resets instead of locking up (F9)
    main_hardfault_asm.S was assembled for cortex-m3 (tst.w/ITE/b.w); on the M0 the entry faulted inside HardFault and locked
    the core, so HardFault_Handler_C and NVIC_SystemReset never ran, leaving the heater's hardware PWM at its last duty (f0
    has no watchdog). bkpt() in the C handlers also locked up with no debugger: now empty on the M0, DHCSR-guarded on the M3.
    Proven on QEMU's Cortex-M0 (microbit) by test_fault_entry_m0.py: fixed entry reaches the C handler; upstream's entry and
    BKPT-in-handler lock up. f0_module and f1_dual build. Upstream's bug. Watchdog left as owner decis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
    [main.cpp, test_fault_entry_m0.py]
2026-10-24 firmware: analog-output test mode now steps 1.00/2.50/4.00 V (16-bit system time wrapped at 6.55 s, so it never left 1.00 V); host tests F3-F6
    test/aux_out builds the production auxout.cpp, pump_dac.cpp and can_helper.cpp with the real f0_module config and fake
    ChibiOS headers: 16 tests (duty vs 5.04 V full scale, clamping, only TIM3 ch index 3 written, pump untouched, zero before
    PB1 goes to AF1, the AFR curve, the validity window, test mode across the tick wrap, CAN TIME_IMMEDIATE). Against the old
    auxout.cpp the test-mode test fails at every 2.50/4.00 V point. Fix uses the 64-bit chVTGetTimeStamp(): no RAM, +544 B flash.
    Curve moved to aux_curve.h (shared with the tests); trim macros over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
    [aux_curve.h, auxout.cpp, fakes.cpp, fakes.h, hal.h, port.cpp, test_aux_out.cpp]
2026-10-24 work: F8 static stack estimate per thread from the f0 ELF; all fit, smallest margin 80 B (pump), CAN TX 312/512 B
    stack_estimate.py reads frames (push, sub sp) and direct/tail calls from the disassembly, charges indirect calls the
    deepest address-taken function, separates real recursion from loops the over-approximation creates, and compares each
    thread's depth with its THD_WORKING_AREA size (re-read from the sources); main and exception stacks from linker symbols.
    Fails on a non-f0 build or a missing thread. In run_all. Runtime high-water on hardware still to do.
    Claude-Session: https://claude.ai/code/session_013ZVt2aLpmrSY8uzxABcZfb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
    [stack_estimate.py]
2026-10-24 test: heater Update() coverage (F7): duty law, 12 V cap, 23 V cut-off, standalone start, sensor disconnect, boundaries
    13 tests drive HeaterControllerBase::Update() every 50 ms with the board's timings; two mutants (cut-off 24 V, >= on
    closed-loop entry) each fail one. Host suite 64/64. No firmware change. Recorded: without CAN the f0 assumes a 13 V supply
    although the module routes VBatt_Sense to PB0 through a 100k/10k divider; reading it is owner decision D11 (RAM).
    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
2026-10-24 work: C7 inspected: PWM return gap is JP2's pour opening plus the PWM's own layer swap; accept recommended, gate decision folded into D2
    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
2026-10-24 work: C2 build-around: feedback after R11 holds 1-5 V within 3 mV into any tested receiver load (sim/load_accuracy.sh); OOM lesson
    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
2026-10-24 board_carrier: r37: stage on the top (D9), feedback from J3-5 after R11 (C2), R9 1206 (D1), M3 holes (D8); 0 new DRC, 0 open, layout review clean. work: raw DRC advisory per D2, module-identical check
    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
    [board_carrier.kicad_pcb, board_carrier.kicad_sch]
2026-10-24 firmware: D10 independent watchdog refreshed by the heater loop (0 B RAM, +44 B flash); host tests, bench self-test flag. work: host gtest suite in run_all
    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
2026-10-24 board_carrier: r38: merge same-net vias drilled too close (hole_to_hole hidden as a warning since about r26). work: DRC delta counts fab-relevant warnings; lesson
    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
    [board_carrier.kicad_pcb]
2026-10-24 board_carrier: r39: silkscreen pass (gen/silk.py): readable labels that belong to their part, jumper function labels TEST and 120R
    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
    [board_carrier.kicad_pcb]
2026-10-24 board_carrier: r40: silkscreen stroke 0.16 mm. work: fab export (gen/export_fab.py), EasyEDA-measured JLC rotations and pin names (checks/jlc_rotation.py, D2 pairing by function), fab candidate check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
    [C12519.json, C133648.json, C13585.json, C14663.json, C151279.json, C1523.json, C1525.json, C1567.json]
2026-10-24 work: audit hand-off for round 4 (r40 board, fab candidate, firmware D10); assembly drawing from the fab layer
    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
2026-10-24 work: JLC part class and LCSC stock for the r40 BOM (7 Extended; low stock on C13585, C14663, C7934)
    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
2026-10-24 work: AGENTS.md turn-taking between Claude and Codex for circuit and theory audits
    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
2026-10-24 board_carrier: r41: copper keep-out 3.6 mm around the mounting holes, both layers (pour was 0.3 mm from them). work: A3 expectation after the feedback move
    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
    [board_carrier.kicad_pcb]
2026-10-24 work: status page, README, STATE stages and audit hand-off brought to r41
    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
2026-10-24 work: handoff current state and raw output at r41
    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
2026-10-24 work: independently review r41 circuit and verification coverage
    Reproduce cable stability and full-scale loading; retain two convergence failures. Add ARMv6-M stack-bound counterexample and simulator failure-path tests. Record two open verifier bugs without changing design files.
2026-10-24 work: round 4 follow-through (local): stack checker reads literal pools and fails unbounded indirect calls (Codex R41-CX1), sim wrappers fail on missing results (R41-CX2), both with regression tests;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
    [stack_estimate.py, test_sim_failures.py, test_stack_estimate.py]
2026-10-24 firmware: heater: clamp the effective voltage at 0, so a sensor hotter than target gets no heat instead of a squared negative voltage (upstream heater_control.cpp; found by Codex round 4); host test 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
    Local branch for the owner's decision; not merged into analog-out.
    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
2026-10-24 work: angled perspective renders (front, connector end, underneath) on the status page
    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
2026-10-25 board_carrier, firmware: output low from reset (outside review B1): R3 100k -> 4.7k (C25900, Basic) and PB1 pull-down in the app and bootloader board.h; invalid lambda -> 5.0 V (N1, fail lean so a cl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
    Layout unchanged (0 parts moved, same tracks and vias); 23 checks, 0 failed, 2 advisory.
    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
    [C25900.json, board_carrier.kicad_pcb, board_carrier.kicad_sch]
2026-10-25 work: Codex's unfinished round-4 second pass, committed as left (heater test, R9-fed corner retries, Gerber renders) with a note
    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
2026-10-25 work: outside review of r41 (Claude, for sidewinderzz), 2026-10-24
    Adds only work/audit/claude-sidewinderzz-2026-10-24/ per REVIEW.md: FINDINGS.md
    (verdict, B1 boot-time full-scale output, R1 clamp headroom, notes), the clamp
    model deck and its results, a pcbnew-free board reader and the netlist it read.
    Claude-Session: https://claude.ai/code/session_01RWN6nFpuLK3gcB7a61fjeV
2026-10-25 work: ROADMAP.md (route to a working controller: steps, firmware and flashing, manufacturer choice, costs, shopping list); round 5 (cousin's Claude) in AUDIT.md with follow-through; live JLC stock ch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
2026-10-25 work: R1 full-scale sweep on TI's model with clamps, R9 supply and +5V tolerance: 27 cases valid; 10k/100k within +2 mV everywhere, 4.7k low only when +5V is low; accepted as a documented limit, benc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
2026-10-25 work: module pre-order check (jlc_rotation.py --board module): 57 parts, upstream's CPL agrees on 56; Q1 VND14 (TO-252) needs 0 deg not 180, corrected in the staged CPL; XC6206 EasyEDA pin names over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
    [C106862.json, C11702.json, C12624.json, C19666.json, C2087389.json, C2286.json, C2288.json, C23221.json]
2026-10-25 board_carrier: J3 bottom labels: OUT (J3-5), GND (J3-7), and upstream's 12V under J3-6 restored (deleted since r1). work: docs/wiring.md (J3, sensor plug, SWD); SWD pad diagram from the board files (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
    DRC delta 0/0; 24 checks, 0 failed, 2 advisory.
    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
    [board_carrier.kicad_pcb]
2026-10-25 work: review pack includes the wiring sheet and SWD diagram
    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
2026-10-25 work: SWD route chosen (owner, D4): HiLetgo ST-Link V2 clone + TC2030-IDC-NL + jumpers; wiring table and flash command in docs/wiring.md, shopping list
    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
2026-10-25 work: reviewer docs for a cold agent: task list TK1-TK13, findings template, chat prompt, plain-text part/net lists, pack zip
    REVIEW.md leads with the three rules earlier rounds broke (work without waiting, write up and commit after
    every task, stop at a quarter budget) and two routes (agent with the repo, chat with one zip).
    review/TASKS.md: each task has a question, files, how to check with and without a shell, and a done line.
    audit_pack.py: =NAME renames, refuses basename collisions (the module's README.md and not-fitted.csv were
    overwriting the carrier's), writes INDEX.md, uses review/PROMPT.md. New check review_docs.py (25 checks).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
    [pack_extras.py, review_docs.py]
2026-10-25 work: CLAUDE.md: analog-stage passive sizes as on the board (R6/R8 are 0603, not 1206)
    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
2026-10-25 work: round 6 TK1 carrier assembly row audit
2026-10-25 work: round 6 TK5 heater clamp recovery sequences
2026-10-25 work: round 6 TK8 conditional fault currents and backfeed risk
2026-10-25 work: round 6 TK10 layout metrics and assembly edge clearance
2026-10-25 work: round 6 TK11 wiring and debugger pin audit
2026-10-25 work, board_carrier: round 6 (Codex/Astra, PR #2) answered: stack checker and sim wrappers fixed, R9 pulse-proof
    - R6-S6 (BUG): stack_estimate.py cut every loop through an indirect call, so real recursion through a
    pointer passed. Now every loop fails; five callers get a source-read target table (NARROW) cross-checked
    against their literal pools; -v no longer hangs. Regression case 4 fails on the old checker.
    - R6-S8 (BUG): an aborted ngspice transient exits 0 with finite zeros and passed all three wrappers.
    sim/completed.sh: the run must reach its stop time with no abort message. 9 new fake cases fail on the
    old wrappers. Real runs: stability 25/25, load 48/48, full scale 27/27 (ide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
    [C844867.json, board_carrier.kicad_pcb, board_carrier.kicad_sch]
2026-10-25 work: round 7 TK5 verify fab delta stock and isolated full checks
    [TK5-carrier-bom.csv, TK5-not-fitted.csv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]
2026-10-25 work: round 7 TK6 test sampler and heater fault latency
2026-10-25 work: round 7 (Codex/Astra, PR #3) answered: surge budget conditional, +5V load list and A8, review headers; release gate reads the latest round
    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
2026-10-25 work: release flyboy-o2-v1 (carrier + module fab files) through release.py; not ordered yet
    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
    [carrier-bom.csv, carrier-not-fitted.csv, module-bom.csv, module-not-fitted.csv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]
2026-10-25 work: owner's first-order quantity (2 assembled of 5)
    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
2026-10-25 work: verify both frozen assembly sets and module fabrication geometry
2026-10-25 work: round 8 OR1/OR2 answered: socketed module (Mill-Max 310 sockets, 350 pins), SWD plan; field reports from the rusEFI forum thread
    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
2026-10-26 work: socket and pin stock (DigiKey, via pcbparts.dev)
    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
